rowangifford/harvestgeek/Hardware/Kicad/base_station_rev1.2_16MAY/gerbers/base_station_rev1.1-GERBERS_reduced_outline/README.txt

Harvest Geek Base Station V1.1
Engineer: Rowan Gifford
Contact: rowan.gifford@gmail.com
Tel: +447979880940
Date: 03 July 2014

2 layer PTH 1.6mm FR4 1 oz Cu I.S.

PCB size: 99mm x 57.72mm      (Ver 2, reduced outline 04 July 2014)

Files:

BASESTATION_BOARD_OUTLINE.gbr - PCB outline, standard 2mm router, no panalisation
BASESTATION_BOTMASK.gbs - Bottom layer solder mask
BASESTATION_BOTTOM.gbl - Bottom copper layer
BASESTATION_TOPMASK.gts - Top layer solder mask
BASESTATION_TOP.gtl - Top copper layer
BASESTATION_SILKTOP.gto - Top layer silkscreen
BASESTATION_DRILL.drl - Drill file, all plated through hole.
BASESTATION_ASSY.gto - Assembly file, shows component placement and references for population
