rowangifford/harvestgeek/Hardware/BOM/BoM_MoistureProbe_Rev1.0.xlsm

Project components for 1 prototype
 | Moisture Probe BOM
 | Version 1.0 (RG)
 | Date 16/06/2015
Item | Schematics Ref | Qty | Description | Manufacturer P/N | Manufacturer | Customer Supplied? | Component Fitted? | Packaging | Internet link
1 | K1 | 1 | CONN TERM BLK 3POS 3.5MM R/A PCB | 1824430000 | Weidmuller | No | Yes | TH | http://www.digikey.com/product-detail/en/1824430000/281-2021-ND/1094359
2 | Q1 | 1 | NPN Transistor 40V 0.6A | MMBT2222ALT3G | ON Semiconductor | No | Yes | SOT-23 | http://www.digikey.co.uk/product-detail/en/MMBT2222ALT3G/MMBT2222ALT3GOSTR-ND/1481928
3 | R1, R2 | 2 | 100 Ohm 1/8W Resistor | ESR03EZPJ101 | Rohm | No | Yes | SM-0603 | http://www.digikey.co.uk/product-detail/en/ESR03EZPJ101/RHM100DDKR-ND/1984100
 | Total: | 4
