rowangifford/harvestgeek/Hardware/BOM/BoM_SensorStation_Rev1.3.xlsm

Project components for 1 prototype
 | Sensor Station BOM
 | Version 1.3 (RG)
 | Date 20/06/2015
Item | Schematics Ref | Qty | Description | Manufacturer P/N | Manufacturer | Customer Supplied? | Component Fitted? | Packaging | Internet link
1 | P5 | 1 | CONN TERM BLK 2POS 3.5MM R/A PCB | 1824420000 | Weidmuller | No | Yes | TH | http://www.digikey.com/product-detail/en/1824420000/281-2020-ND/1094358
2 | K1 | 1 | CONN TERM BLK 3POS 3.5MM R/A PCB | 1824430000 | Weidmuller | No | Yes | TH | http://www.digikey.com/product-detail/en/1824430000/281-2021-ND/1094359
3 | CON1 | 1 | CONN RCPT STD MICRO USB TYPE B | 10103594-0001LF | FCI | No | Yes | TH/SMD | http://www.digikey.com/product-detail/en/10103594-0001LF/609-4050-1-ND/2350357
4 | CON2 | 1 | CONN HEADER 6POS .100 STR 15AU | 67996-206HLF | FCI | No | Yes | TH | http://www.digikey.com/product-detail/en/67996-206HLF/609-3210-ND/1878485
5 | U1 | 1 | IC REG LDO 3.3V 0.3A SOT23-3 | AP7333-33SAG-7 | Diodes Inc | No | Yes | SOT-23-3 | http://www.digikey.com/product-detail/en/AP7333-33SAG-7/AP7333-33SAG-7DICT-ND/2270852
6 | U2 | 1 | IC MCU 8BIT 32KB FLASH 44TQFP | ATMEGA32U4-AUR | Atmel | No | Yes | 44-TQFP | http://www.digikey.com/product-detail/en/ATMEGA32U4-AUR/ATMEGA32U4-AURCT-ND/3440960
7 | U3 | 1 | IC VREF SHUNT PREC 2.5V TO-92-3 | LT1009CLP | Texas Instruments | No | Yes | TO-92-3 | http://www.digikey.com/product-detail/en/LT1009CLP/296-9585-5-ND/379789
8 | U4 | 1 | IC LIGHT TO DGTL CONV 6-DFN | TSL2581FN | AMS-TAOS USA Inc | No | Yes | 6-DFN (2x2) | http://www.digikey.com/product-detail/en/TSL2581FN/TSL2581-FNCT-ND/3095315
9 | U5 | 1 | NRF24L01 RF module | NRF24L01 | Nordic | No | Yes | TH | From ebay (look for 2 PCS NRF24L01 2.4GHz)
10 | U6 | 1 | DHT22 temp & humidity sensor | AM2302 (or DHT22) | Aosong | No | Yes | TH | From ebay
11 | U7 | 1 | High side load switch | AP22802AW5-7 | Diodes Inc | No | Yes | SOT-23-5 | http://www.digikey.com/product-detail/en/AP22802AW5-7/AP22802AW5-7DICT-ND/4935003
12 | D1 | 1 | LED GREEN/RED BICOLOR 0606 | LTST-C195KGJRKT | Lite-On Inc | No | Yes | 0606 (1616 Metric) | http://www.digikey.com/product-detail/en/LTST-C195KGJRKT/160-1452-1-ND/386846
13 | SW1 | 1 | SWITCH TACTILE SPST-NO 0.05A 12V | FSM16JH | TE Connectivity | No | Yes | TH | http://www.digikey.com/product-detail/en/FSM16JH/450-1643-ND/1632529
14 | X1 | 1 | CRYSTAL 8MHZ 18PF SMD | ABLS-8.000MHZ-B2-T | Abracon Corporation | No | Yes | HC49/US | http://www.digikey.com/product-detail/en/ABLS-8.000MHZ-B2-T/535-9089-1-ND/675606
15 | FB3 | 1 | FERRITE CHIP 600 OHM 1300MA 0603 | BLM18KG601SN1D | Murata Electronics North America | No | Yes | 0603 (1608 Metric) | http://www.digikey.com/product-detail/en/BLM18KG601SN1D/490-5258-1-ND/1982781
16 | R1 R2 | 2 | RES 22.0 OHM 1/10W 1% 0603 SMD | RC0603FR-0722RL | Yageo | No | Yes | 0603 (1608 Metric) | http://www.digikey.com/product-detail/en/RC0603FR-0722RL/311-22.0HRCT-ND/730002
17 | R5 R6 R7 R8 R11 R13 | 6 | RES 1K OHM 1/10W 1% 0603 SMD | ERJ-3EKF1001V | Panasonic Electronic Components | No | Yes | 0603 (1608 Metric) | http://www.digikey.com/product-detail/en/ERJ-3EKF1001V/P1.00KHCT-ND/198071
18 | R3 R4 R9 R10 R12 R14 R15 | 7 | RES 10K OHM 1/10W 1% 0603 SMD | ERJ-3EKF1002V | Panasonic Electronic Components | No | Yes | 0603 (1608 Metric) | http://www.digikey.com/product-detail/en/ERJ-3EKF1002V/P10.0KHCT-ND/198102
19 | C9 C10 | 2 | CAP CER 18PF 50V 5% NP0 0603 | C1608C0G1H180J080AA | TDK Corporation | No | Yes | 0603 (1608 Metric) | http://www.digikey.com/product-detail/en/C1608C0G1H180J080AA/445-1272-1-ND/567674
20 | C3 C4 C5 C6 C8 C11 C12 C13 C14 C15 C16 C17 C18 C33 | 14 | CAP CER 0.1UF 50V 10% X7R 0603 | GRM188R71H104KA93D | Murata Electronics North America | No | Yes | 0603 (1608 Metric) | http://www.digikey.com/product-detail/en/GRM188R71H104KA93D/490-1519-1-ND/587854
21 | C1 C2 C7 C19 C20 C36 C39 | 7 | CAP CER 1UF 16V 10% X7R 0603 | EMK107B7105KA-T | Taiyo Yuden | No | Yes | 0603 (1608 Metric) | http://www.digikey.com/product-detail/en/EMK107B7105KA-T/587-1241-1-ND/931018
22 | SENS | 1 | THERMISTOR ASSEMBLY 10K OHM | USP10982 | US Sensor | No | No | Not PCB Mounted | http://www.digikey.com/product-detail/en/USP10982/615-1088-ND/2651606
23 | LP1 LP2 | 2 | LIGHT PIPE CLEAR 5MM LENS STRGHT | PLP5-2-750 | Bivar Inc | No | Yes | Optical | http://www.digikey.com/product-detail/en/PLP5-2-750/492-1308-ND/2407218
24 | BOX | 1 | ABS Enclosure - CNC modified | SL-30FTMBT | Polycase | Yes | Yes | Mechanical | http://www.polycase.com/sl-30f
25 | SCREW | 4 | Enclosure/PCB 4x5/8 blk thread forming screw | SCREWS-HL5/8-B | Polycase | Yes | Yes | Mechanical | http://www.polycase.com/sl-30f
26 | SPACER | 1 | ROUND SPACER M3 NYLON 3MM | R30-6700394 | Harwin Inc. | No | Yes | Mechanical | http://www.digikey.co.uk/product-detail/en/R30-6700394/952-1526-ND/2264507
 | Total: | 62
 |  |  | Revision Log
 |  |  | Date | Revision | Engineer | Changes
 |  |  | 20th June 2015 | 1.3 | RG | Added U7,R14,R15,C18,C19,C20
