rowangifford/harvestgeek/Hardware/BOM/BoM_BaseStation_Rev1.2.xlsm

Project components for 1 prototype
 | Sensor Station BOM
 | Version 1.2 (RG)
 | Date 22/05/2015
Item | Schematics Ref | Qty | Description | Manufacturer P/N | Manufacturer | Customer Supplied? | Component Fitted? | Packaging | Internet link
1 | CON1 | 1 | CONN RCPT STD MICRO USB TYPE B | 10103594-0001LF | FCI | No | Yes | TH/SMD | http://www.digikey.com/product-detail/en/10103594-0001LF/609-4050-1-ND/2350357
2 | CON2 | 1 | CONN HEADER 6POS .100 STR 15AU | 67996-206HLF | FCI | No | Yes | TH | http://www.digikey.com/product-detail/en/67996-206HLF/609-3210-ND/1878485
3 | J1 | 1 | CONNECTOR RJ45 | RB1-125BAG1A | Wiznet | No | Yes | TH | http://www.digikey.com/product-search/en?KeyWords=RB1-125BAG1A&WT.z_header=search_go
4 | U1 | 1 | IC REG LDO 3.3V 0.3A SOT23-3 | AP7333-33SAG-7 | Diodes Inc | No | Yes | SOT-23-3 | http://www.digikey.com/product-detail/en/AP7333-33SAG-7/AP7333-33SAG-7DICT-ND/2270852
5 | U2 | 1 | IC MCU 8BIT 32KB FLASH 44TQFP | ATMEGA32U4-AUR | Atmel | No | Yes | 44-TQFP | http://www.digikey.com/product-detail/en/ATMEGA32U4-AUR/ATMEGA32U4-AURCT-ND/3440960
6 | U3 | 1 | IC TCP/IP+MAC+PHY CONTROLLER | W5100 | WIZnet | No | Yes | 80-LQFP (10x10) | http://www.digikey.com/product-detail/en/W5100/1278-1002-ND/3829647
7 | U4 | 1 | LCD COG CHARCTER 20x4 STN BLUE | RX2004A-BIW | Raystar | Yes | Yes | TH | http://octopart.com/rx2004a-biw-raystar-30865298
8 | U5 | 1 | NRF24L01+ RF module | NRF24L01 | Nordic | No | Yes | TH | From ebay (look for 2 PCS NRF24L01 2.4GHz)
9 | U6 | 1 | I2C EEPROM 2KBIT MAC | 24AA02E48T-I/OT | Microchip | No | Yes | SOT-23-5 | http://www.digikey.com/product-detail/en/24AA02E48T-I%2FOT/24AA02E48T-I%2FOTCT-ND/2003468
10 | Q1 | 1 | MOSFET N-CH 60V 300MA SOT-23 | 2N7002,215 | NXP Semiconductors | No | Yes | TO-236AB | http://www.digikey.com/product-detail/en/2N7002,215/568-1369-1-ND/763366
11 | SW1 | 1 | SWITCH TACTILE SPST-NO 0.05A 12V | FSM16JH | TE Connectivity | No | Yes | TH | http://www.digikey.com/product-detail/en/FSM16JH/450-1643-ND/1632529
12 | X1 | 1 | CRYSTAL 8MHZ 18PF SMD | ABLS-8.000MHZ-B2-T | Abracon Corporation | No | Yes | HC49/US | http://www.digikey.com/product-detail/en/ABLS-8.000MHZ-B2-T/535-9089-1-ND/675606
13 | X2 | 1 | CRYSTAL 25MHZ 18PF SMD | ABLS-25.000MHZ-B4-F-T | Abracon Corporation | No | Yes | HC49/US | http://www.digikey.com/product-detail/en/ABLS-25.000MHZ-B4-F-T/535-10235-1-ND/2184270
14 | FB1 FB2 FB3 | 3 | FERRITE CHIP 600 OHM 1300MA 0603 | BLM18KG601SN1D | Murata Electronics North America | No | Yes | 0603 (1608 Metric) | http://www.digikey.com/product-detail/en/BLM18KG601SN1D/490-5258-1-ND/1982781
15 | C26 C27 | 2 | CAP CER 12PF 50V 5% NP0 0603 | C1608C0G1H120J080AA | TDK Corporation | No | Yes | 0603 (1608 Metric) | http://www.digikey.com/product-detail/en/C1608C0G1H120J080AA/445-1270-1-ND/567672
16 | C9 C10 | 2 | CAP CER 18PF 50V 5% NP0 0603 | C1608C0G1H180J080AA | TDK Corporation | No | Yes | 0603 (1608 Metric) | http://www.digikey.com/product-detail/en/C1608C0G1H180J080AA/445-1272-1-ND/567674
17 | C12 | 1 | CAP CER 10000PF 50V 10% X7R 0603 | C0603C103K5RACTU | Kemet | No | Yes | 0603 (1608 Metric) | http://www.digikey.com/product-detail/en/C0603C103K5RACTU/399-1091-1-ND/411366
18 | C3 C4 C5 C6 C8 C22 C23 C25 C28 C29 C30 C33 C34 C35 C37 C38 C40 C41 C42 | 19 | CAP CER 0.1UF 50V 10% X7R 0603 | GRM188R71H104KA93D | Murata Electronics North America | No | Yes | 0603 (1608 Metric) | http://www.digikey.com/product-detail/en/GRM188R71H104KA93D/490-1519-1-ND/587854
19 | C1 C2 C7 C13 C14 C15 C16 C17 C18 C19 C20 C36 C39 | 13 | CAP CER 1UF 16V 10% X7R 0603 | EMK107B7105KA-T | Taiyo Yuden | No | Yes | 0603 (1608 Metric) | http://www.digikey.com/product-detail/en/EMK107B7105KA-T/587-1241-1-ND/931018
20 | C11 C21 C24 C31 C32 | 5 | CAP CER 10UF 6.3V 20% X5R 0603 | 06036D106MAT2A | AVX Corporation | No | Yes | 0603 (1608 Metric) | http://www.digikey.com/product-detail/en/06036D106MAT2A/478-5318-1-ND/1950985
21 | R1 R2 | 2 | RES 22.0 OHM 1/10W 1% 0603 SMD | RC0603FR-0722RL | Yageo | No | No | 0603 (1608 Metric) | http://www.digikey.com/product-detail/en/RC0603FR-0722RL/311-22.0HRCT-ND/730002
22 | R7, R16 | 2 | RES 66.5 OHM 1/10W 1% 0603 SMD | RC0603FR-0766R5L | Yageo | No | Yes | 0603 (1608 Metric) | http://www.digikey.com/product-detail/en/RC0603FR-0766R5L/311-66.5HRTR-ND/727347
23 | R17 R18 R19 R20 | 4 | RES 49.9 OHM 1/10W 1% 0603 SMD | RC0603FR-0749R9L | Yageo | Yes | Yes | 0603 (1608 Metric) | http://www.digikey.com/product-detail/en/RC0603FR-0749R9L/311-49.9HRCT-ND/730211
24 | R15 | 1 | RES 300 OHM 1/10W 1% 0603 SMD | ERJ-3EKF3000V | Panasonic Electronic Components | Yes | Yes | 0603 (1608 Metric) | http://www.digikey.com/product-detail/en/ERJ-3EKF3000V/P300HCT-ND/1746756
25 | R11 R13 R14 | 3 | RES 1K OHM 1/10W 1% 0603 SMD | ERJ-3EKF1001V | Panasonic Electronic Components | No | Yes | 0603 (1608 Metric) | http://www.digikey.com/product-detail/en/ERJ-3EKF1001V/P1.00KHCT-ND/198071
26 | R3 R4 R5 R6 R10 R12, R21, R22 | 8 | RES 10K OHM 1/10W 1% 0603 SMD | ERJ-3EKF1002V | Panasonic Electronic Components | No | Yes | 0603 (1608 Metric) | http://www.digikey.com/product-detail/en/ERJ-3EKF1002V/P10.0KHCT-ND/198102
27 | R9 | 1 | RES 12K OHM 1/10W 1% 0603 SMD | ERJ-3EKF1202V | Panasonic Electronic Components | No | Yes | 0603 (1608 Metric) | http://www.digikey.com/product-detail/en/ERJ-3EKF1202V/P12.0KHCT-ND/1746728
28 | R8 | 1 | RES 1.00M OHM 1/10W 1% 0603 SMD | RC0603FR-071ML | Yageo | No | Yes | 0603 (1608 Metric) | http://www.digikey.com/product-detail/en/RC0603FR-071ML/311-1.00MHRCT-ND/729791
29 | BOX | 1 | ABS Enclosure - CNC modified | SL-42FXXT | Polycase | Yes | Yes | Mechanical | http://www.polycase.com/sl-42f
30 | SCREW | 4 | Enclosure/PCB 4x1 blk thread forming screw | SCREWS-HL1-BR | Polycase | Yes | Yes | Mechanical | http://www.polycase.com/sl-42f
31 | SPACER | 4 | ROUND SPACER M3 NYLON 3MM | R30-6700394 | Harwin Inc. | No | Yes | Mechanical | http://www.digikey.co.uk/product-detail/en/R30-6700394/952-1526-ND/2264507
 | Total: | 89
 |  |  |  | Revision Log
 |  |  |  | Date | Revision | Engineer | Changes
 |  |  |  | 3rd June 2014 | 1.1 | RG | Added item 26, SW1
 |  |  |  | 3rd July 2014 | 1.1 | RG | Changed U4 to RX2004-BIW character display. Added R7 R16 LED backlight resistors, R21 R22 I2C Pullups
 |  |  |  | 17th May 2014 | 1.2 | RG | Added U6 EEPROM, Mechanical spacers, changed enclosure and re-order
