rowangifford/harvestgeek/Hardware/Manufacturing Outputs/Moisture Probe/moisture_probe_rev1.0_manufacturing_files/README.txt

Harvest Geek Moisture Probe V1.0
Engineer: Rowan Gifford
Contact: rowan.gifford@gmail.com
Date: 16th June 2015

2 layer PTH 1.6mm FR4 1 oz Cu ENIG
PCB size: 21mm x 64mm

No components or silk bottom layer.

Drill file:
Units: mm
Zero's Format: Decimal
File Format: PostScript
Drill origin: Fiducial 1 0,0

Files:

PROBE_BOARD_OUTLINE.gbr - PCB outline, standard 2mm router, no panalisation
PROBE_BOTTOM_MASK.gbr - Bottom layer solder mask
PROBE_BOTTOM_COPPER.gbr - Bottom copper layer
PROBE_TOP_MASK.gbr - Top layer solder mask
PROBE_TOP_COPPER.gbr - Top copper layer
PROBE_TOP_PASTE.gbr - Top solde paste layer (no paste on bottom layer)
PROBE_TOP_SILK.gbr - Top layer silkscreen (no silkscreen on bottom layer)
PROBE_DRILL.drl - Drill file, all plated through hole.
PROBE_TOP_ASSY.pdf - Top assembly file, shows component placement and references for population
PROBE_TOP_POS.pos - Top layer pick and place position file. Origin 0,0 is located at fiducial FID1. Zero orientation follows IPC-7351C Level A (Pin 1 in Upper left). No SMD on bottom layer.
