rowangifford/harvestgeek/Hardware/Manufacturing Outputs/Base Station/base_station_PCB_guide.pdf

## Harvest Geek Base Station PCB Assembly Guide

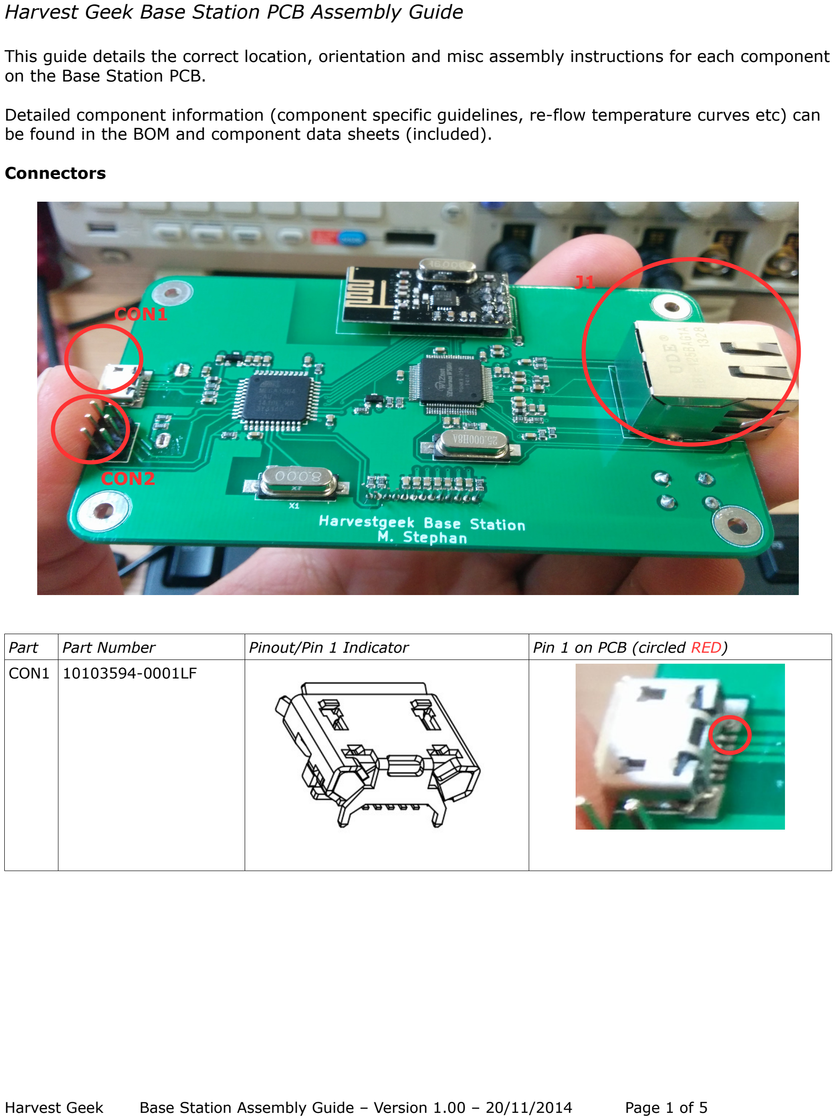
[picture p15: page 1]

This guide details the correct location, orientation and misc assembly instructions for each component on the Base Station PCB.

Detailed component information (component specific guidelines, re-flow temperature curves etc) can be found in the BOM and component data sheets (included).

Connectors

Part | Part Number | Pinout/Pin 1 Indicator | Pin 1 on PCB (circled RED)
CON1 | 10103594-0001LF
Harvest Geek | Base Station Assembly Guide – Version 1.00 – 20/11/2014 | Page 1 of 5

J1

### CON1

### CON2

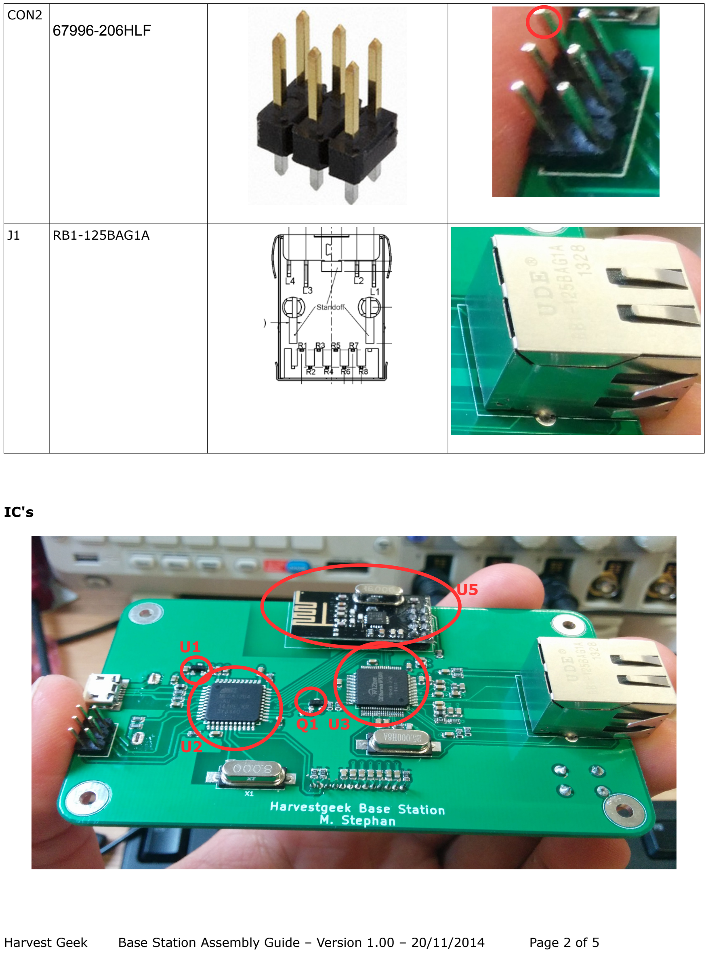
[picture p16: page 2]

CON2 | 67996-206HLF
J1 | RB1-125BAG1A

IC's

Harvest Geek | Base Station Assembly Guide – Version 1.00 – 20/11/2014 | Page 2 of 5

U1

U2

Q1 U3

U5

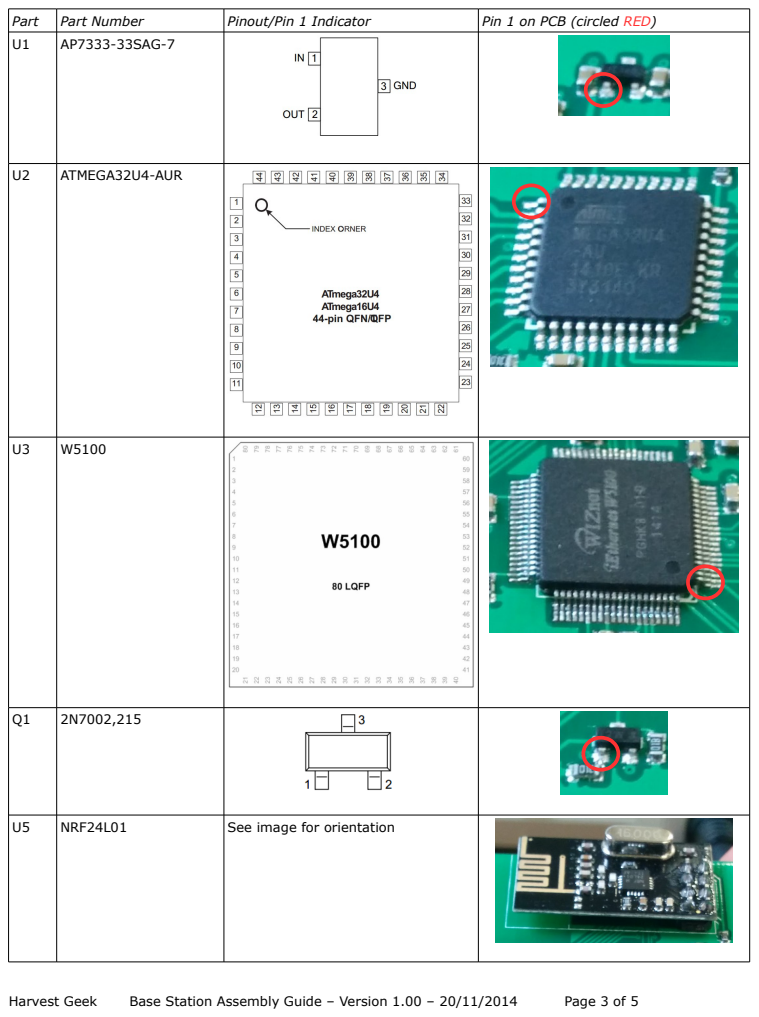
[picture p17: page 3]
Harvest Geek; Base Station Assembly Guide – Version 1.00 – 20/11/2014; Page 3 of 5

Part | Part Number | Pinout/Pin 1 Indicator | Pin 1 on PCB (circled RED)
U1 | AP7333-33SAG-7

U2 | ATMEGA32U4-AUR

U5 | NRF24L01 | See image for orientation

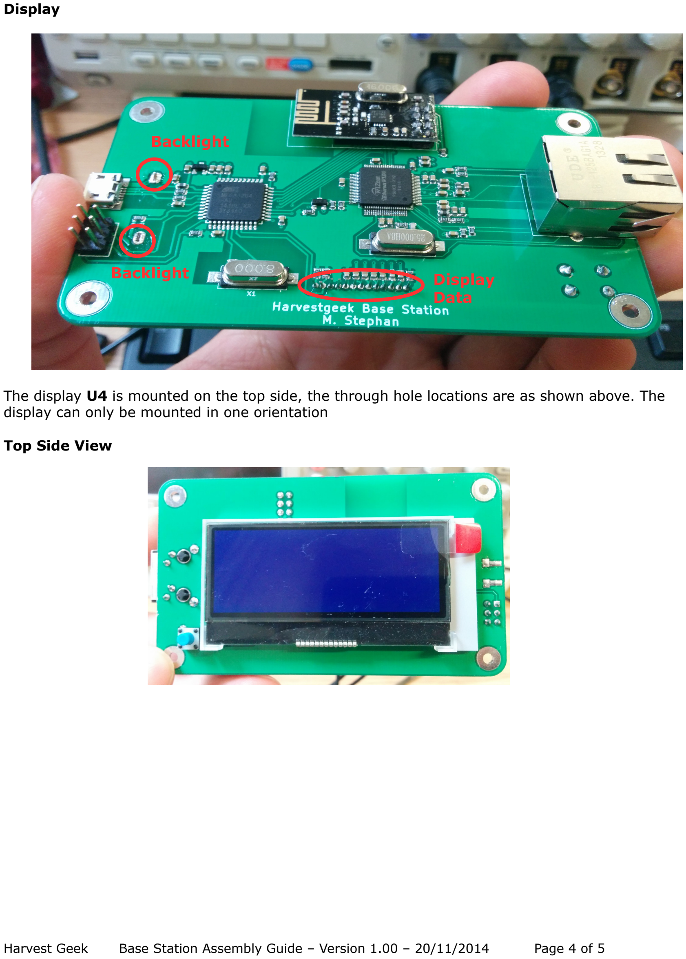
[picture p18: page 4]

Display

The display U4 is mounted on the top side, the through hole locations are as shown above. The display can only be mounted in one orientation

Top Side View

Harvest Geek | Base Station Assembly Guide – Version 1.00 – 20/11/2014 | Page 4 of 5

### Backlight

Backlight | Display Data

Push Button Switch SW1

To be mounted on the TOP side as pictured.

Passives

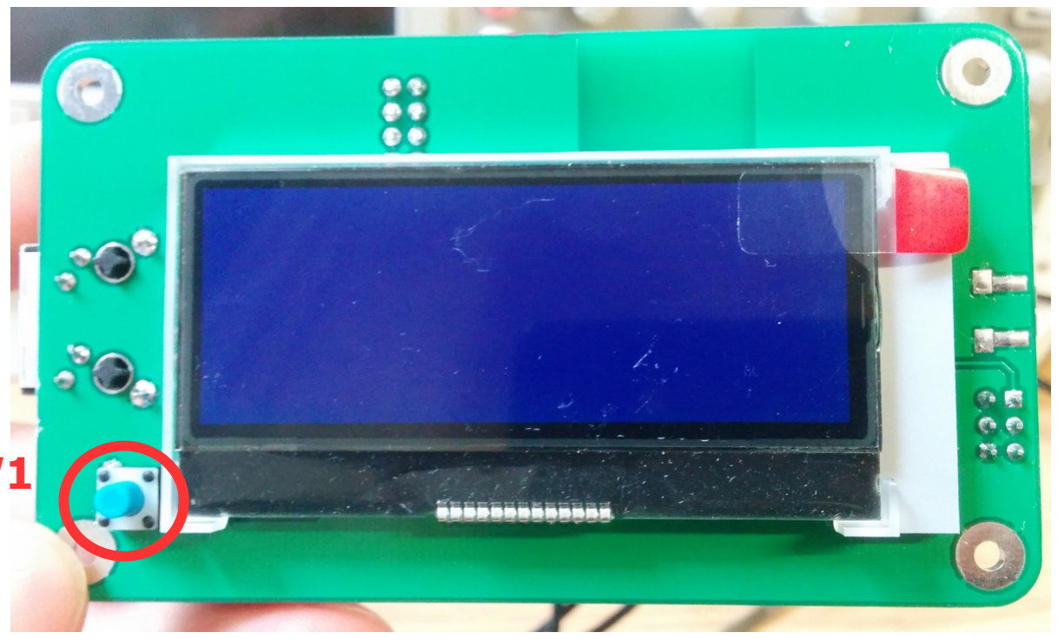
[picture p19: figure]

Capacitors, resistors, inductors and non-polarised component not detailed as they are not orientation specific. See BOM.

Harvest Geek | Base Station Assembly Guide – Version 1.00 – 20/11/2014 | Page 5 of 5

SW1
