rowangifford/harvestgeek/Hardware/Manufacturing Outputs/Sensor Station/sensor_station_PCB_guide.pdf

## Harvest Geek Sensor Station PCB Assembly Guide

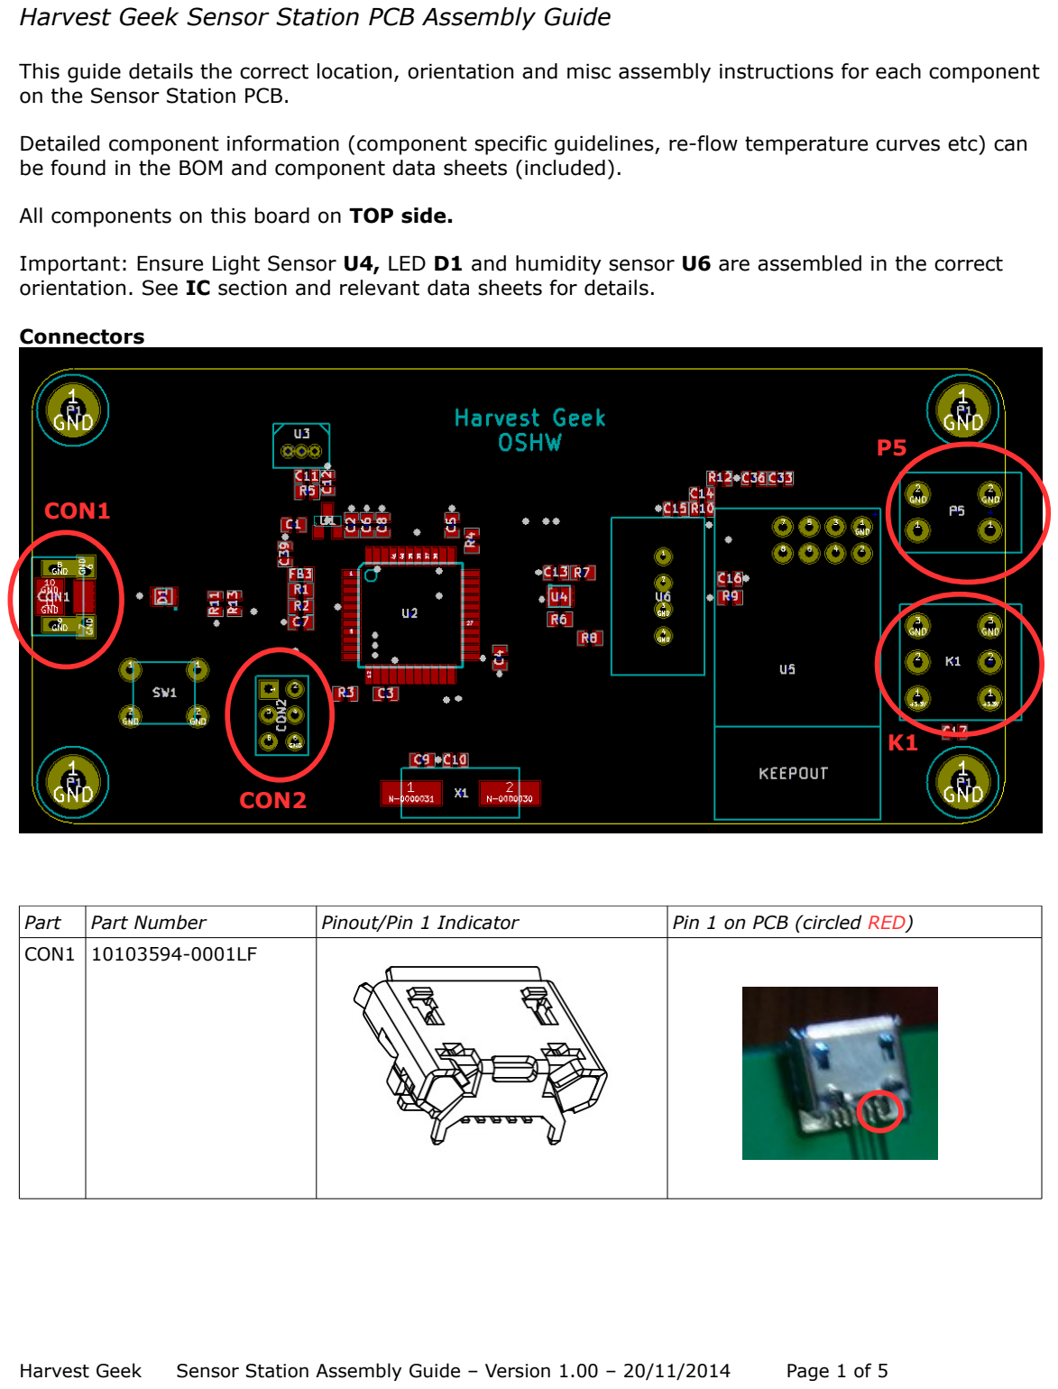
[picture p20: page 1]

This guide details the correct location, orientation and misc assembly instructions for each component on the Sensor Station PCB.

Detailed component information (component specific guidelines, re-flow temperature curves etc) can be found in the BOM and component data sheets (included).

All components on this board on TOP side.

Important: Ensure Light Sensor U4, LED D1 and humidity sensor U6 are assembled in the correct orientation. See IC section and relevant data sheets for details.

Connectors

Part | Part Number | Pinout/Pin 1 Indicator | Pin 1 on PCB (circled RED)
CON1 | 10103594-0001LF
Harvest Geek | Sensor Station Assembly Guide – Version 1.00 – 20/11/2014 | Page 1 of 5

K1

### CON1

### CON2

P5

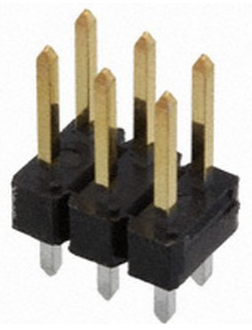
[picture p21: figure]

CON2 | 67996-206HLF

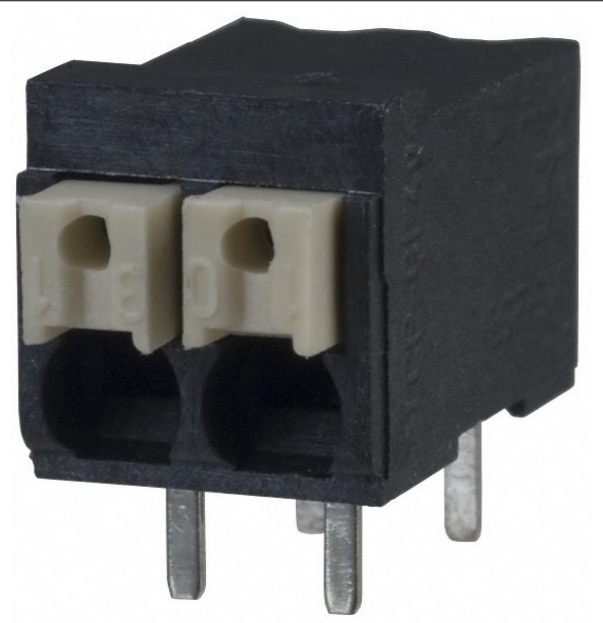
[picture p22: figure]
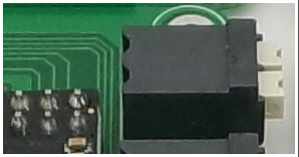
[picture p23: figure]

P5 | 1824420000

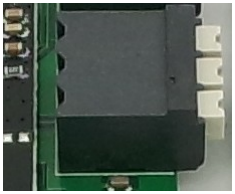
[picture p24: figure]
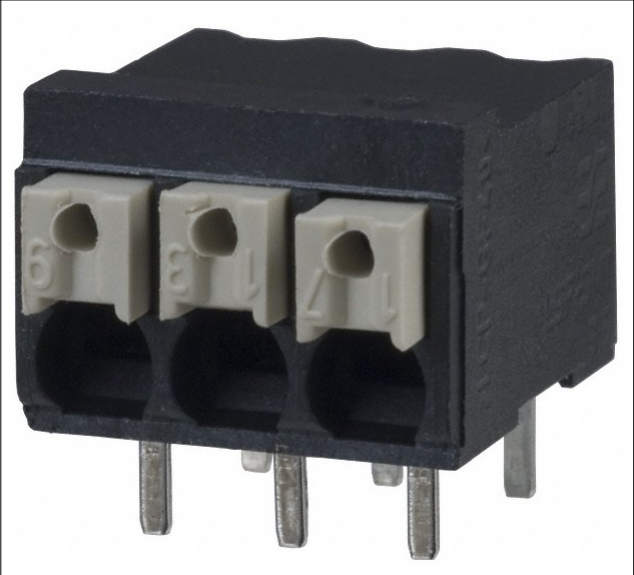
[picture p25: figure]

K1 | 1824430000
Harvest Geek | Sensor Station Assembly Guide – Version 1.00 – 20/11/2014 | Page 2 of 5

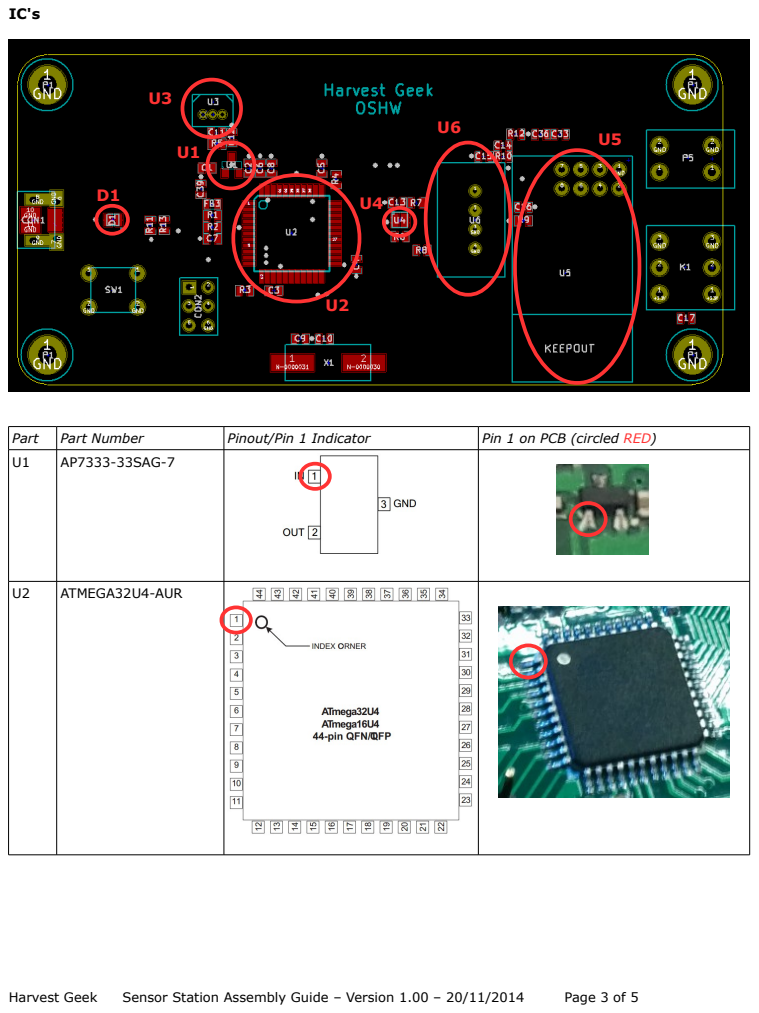
[picture p26: page 3]
Harvest Geek; Sensor Station Assembly Guide – Version 1.00 – 20/11/2014; Page 3 of 5

Part | Part Number | Pinout/Pin 1 Indicator | Pin 1 on PCB (circled RED)
U1 | AP7333-33SAG-7

U2 | ATMEGA32U4-AUR

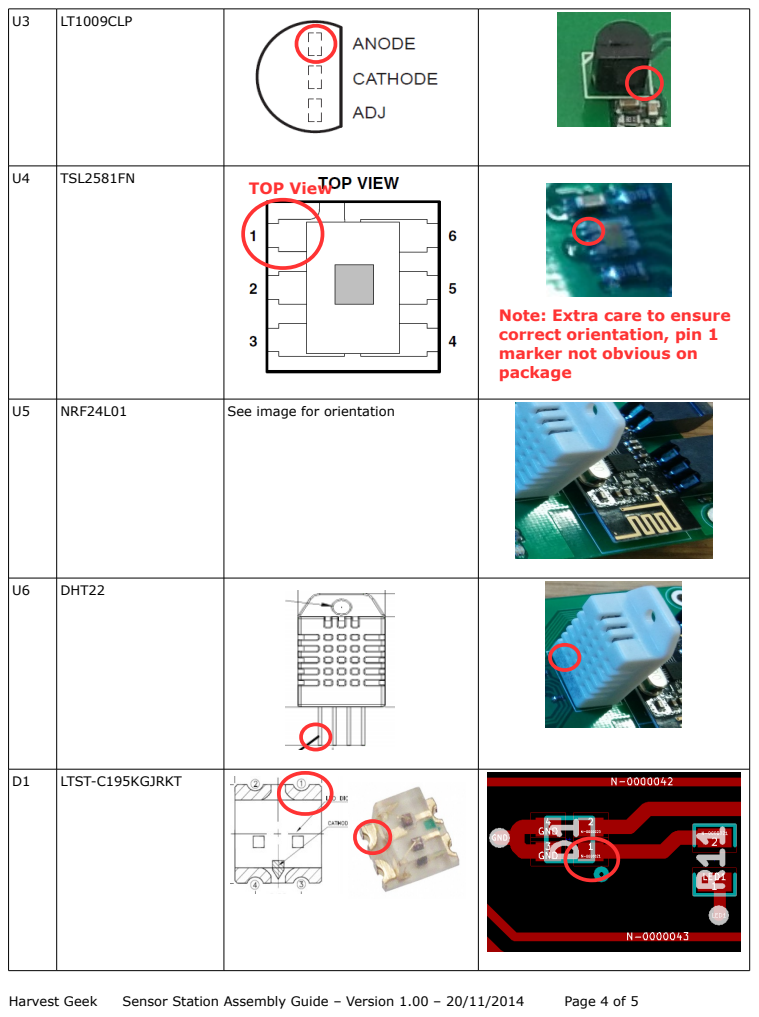
[picture p27: page 4]
Harvest Geek; Sensor Station Assembly Guide – Version 1.00 – 20/11/2014; Page 4 of 5

U3 | LT1009CLP

U4 | TSL2581FN | TOP View | Note: Extra care to ensure correct orientation, pin 1 marker not obvious on package

U5 | NRF24L01 | See image for orientation

U6 | DHT22

D1 | LTST-C195KGJRKT

Push Button Switch SW1

To be mounted on the TOP side as pictured.

Passives

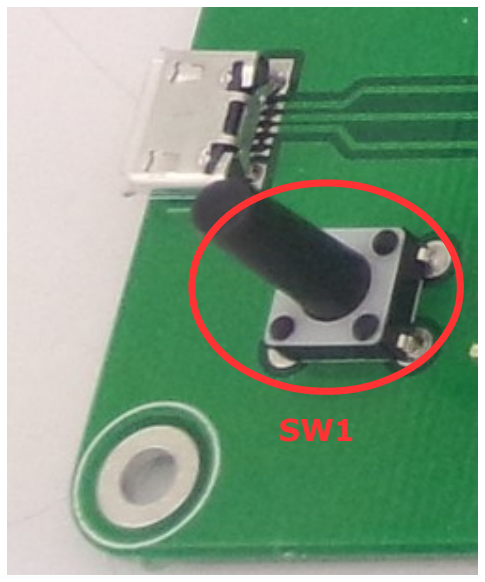
[picture p28: figure]

Capacitors, resistors, inductors and non-polarised component not detailed as they are not orientation specific. See BOM.

Harvest Geek | Sensor Station Assembly Guide – Version 1.00 – 20/11/2014 | Page 5 of 5
