rowangifford/harvestgeek/Hardware/Manufacturing Outputs/Sensor Station/sensor_station_TEST_procedure.pdf

### Harvest Geek Sensor Station Test Procedure

Follow the below power on test procedure after component assembly and firmware burning.

1. Insert 5V power (micro USB cable) as shown below
2. Inspect LED D1 (circled below, top side PCB shown) and asses against PASS or FAIL criteria in table below.
3. If unit meets a FAIL criteria fill out a failure mode document.

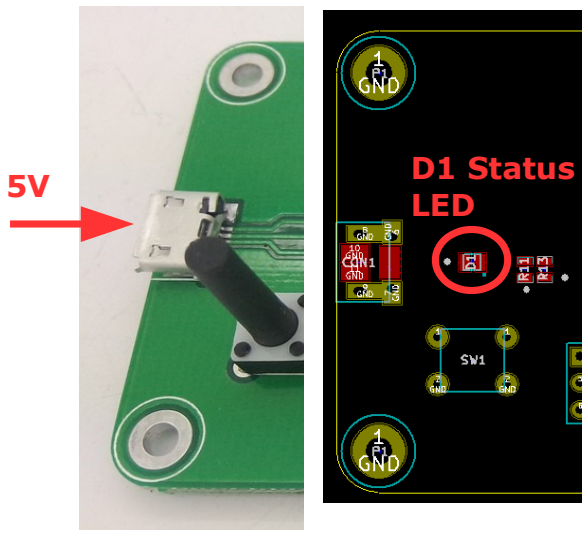
[picture p30: figure]
D1 Status; LED

PASS

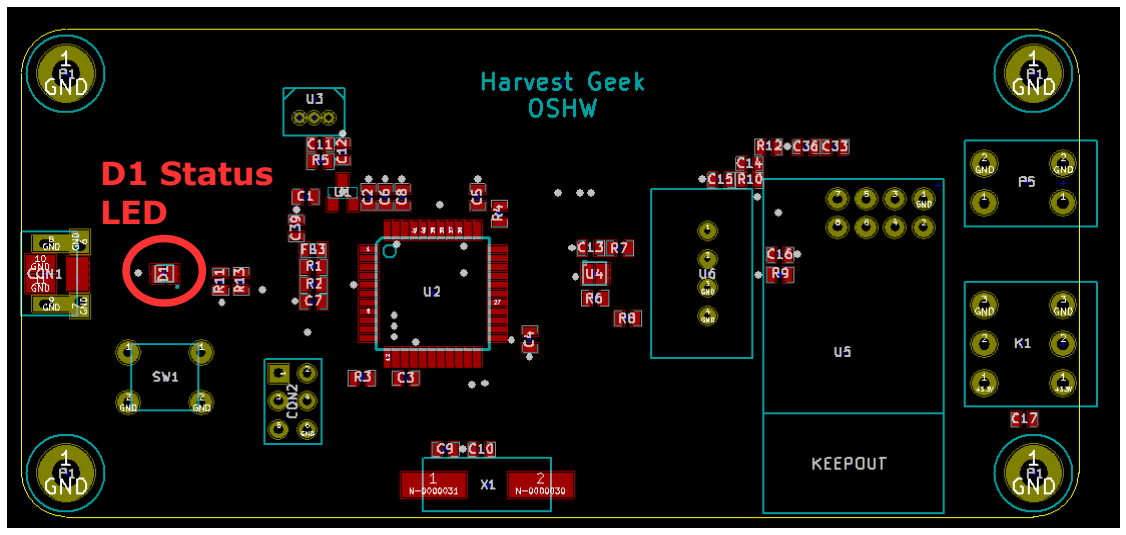
[picture p31: figure]

Light Status | Status
Blinking GREEN | OK, not connected to base station
Solid GREEN | OK, connected to base station

FAIL

Light Status | Error
Solid RED | Light sensor communication
Blinking RED | Humidity sensor communication
Solid GREEN & RED | NRF module communication
Blinking alternately RED & GREEN | No PID in EEPROM
NO light | LED failure
Harvest Geek | Sensor Station Test Procedure – Version 1.00 – 20/11/2014 | Page 1 of 2

### Failure mode documents

Light Status | Error | Check | Test Operator | Date
Solid RED | Light sensor | □
Blinking RED | Humidity sensor | □
Solid GREEN & RED | NRF module | □
Blinking alternately RED & GREEN | No PID in EEPROM | □
NO light | LED failure | □
Light Status | Error | Check | Test Operator | Date
Solid RED | Light sensor | □
Blinking RED | Humidity sensor | □
Solid GREEN & RED | NRF module | □
Blinking alternately RED & GREEN | No PID in EEPROM | □
NO light | LED failure | □
Light Status | Error | Check | Test Operator | Date
Solid RED | Light sensor | □
Blinking RED | Humidity sensor | □
Solid GREEN & RED | NRF module | □
Blinking alternately RED & GREEN | No PID in EEPROM | □
NO light | LED failure | □
Light Status | Error | Check | Test Operator | Date
Solid RED | Light sensor | □
Blinking RED | Humidity sensor | □
Solid GREEN & RED | NRF module | □
Blinking alternately RED & GREEN | No PID in EEPROM | □
NO light | LED failure | □
Light Status | Error | Check | Test Operator | Date
Solid RED | Light sensor | □
Blinking RED | Humidity sensor | □
Solid GREEN & RED | NRF module | □
Blinking alternately RED & GREEN | No PID in EEPROM | □
NO light | LED failure | □
Harvest Geek | Sensor Station Test Procedure – Version 1.00 – 20/11/2014 | Page 2 of 2
