rowangifford/harvestgeek/Hardware/Kicad/Moisture_probe_rev1.0_07JUN/moisture_probe-F_SilkS.pdf

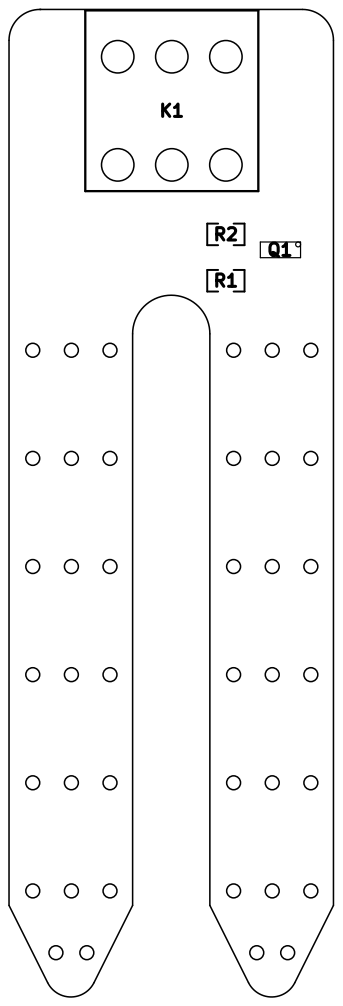
[picture p32: page 1]
