rowangifford/harvestgeek/Hardware/Kicad/base_station_rev1.2_16MAY/schematics_rev1.1_RG.pdf

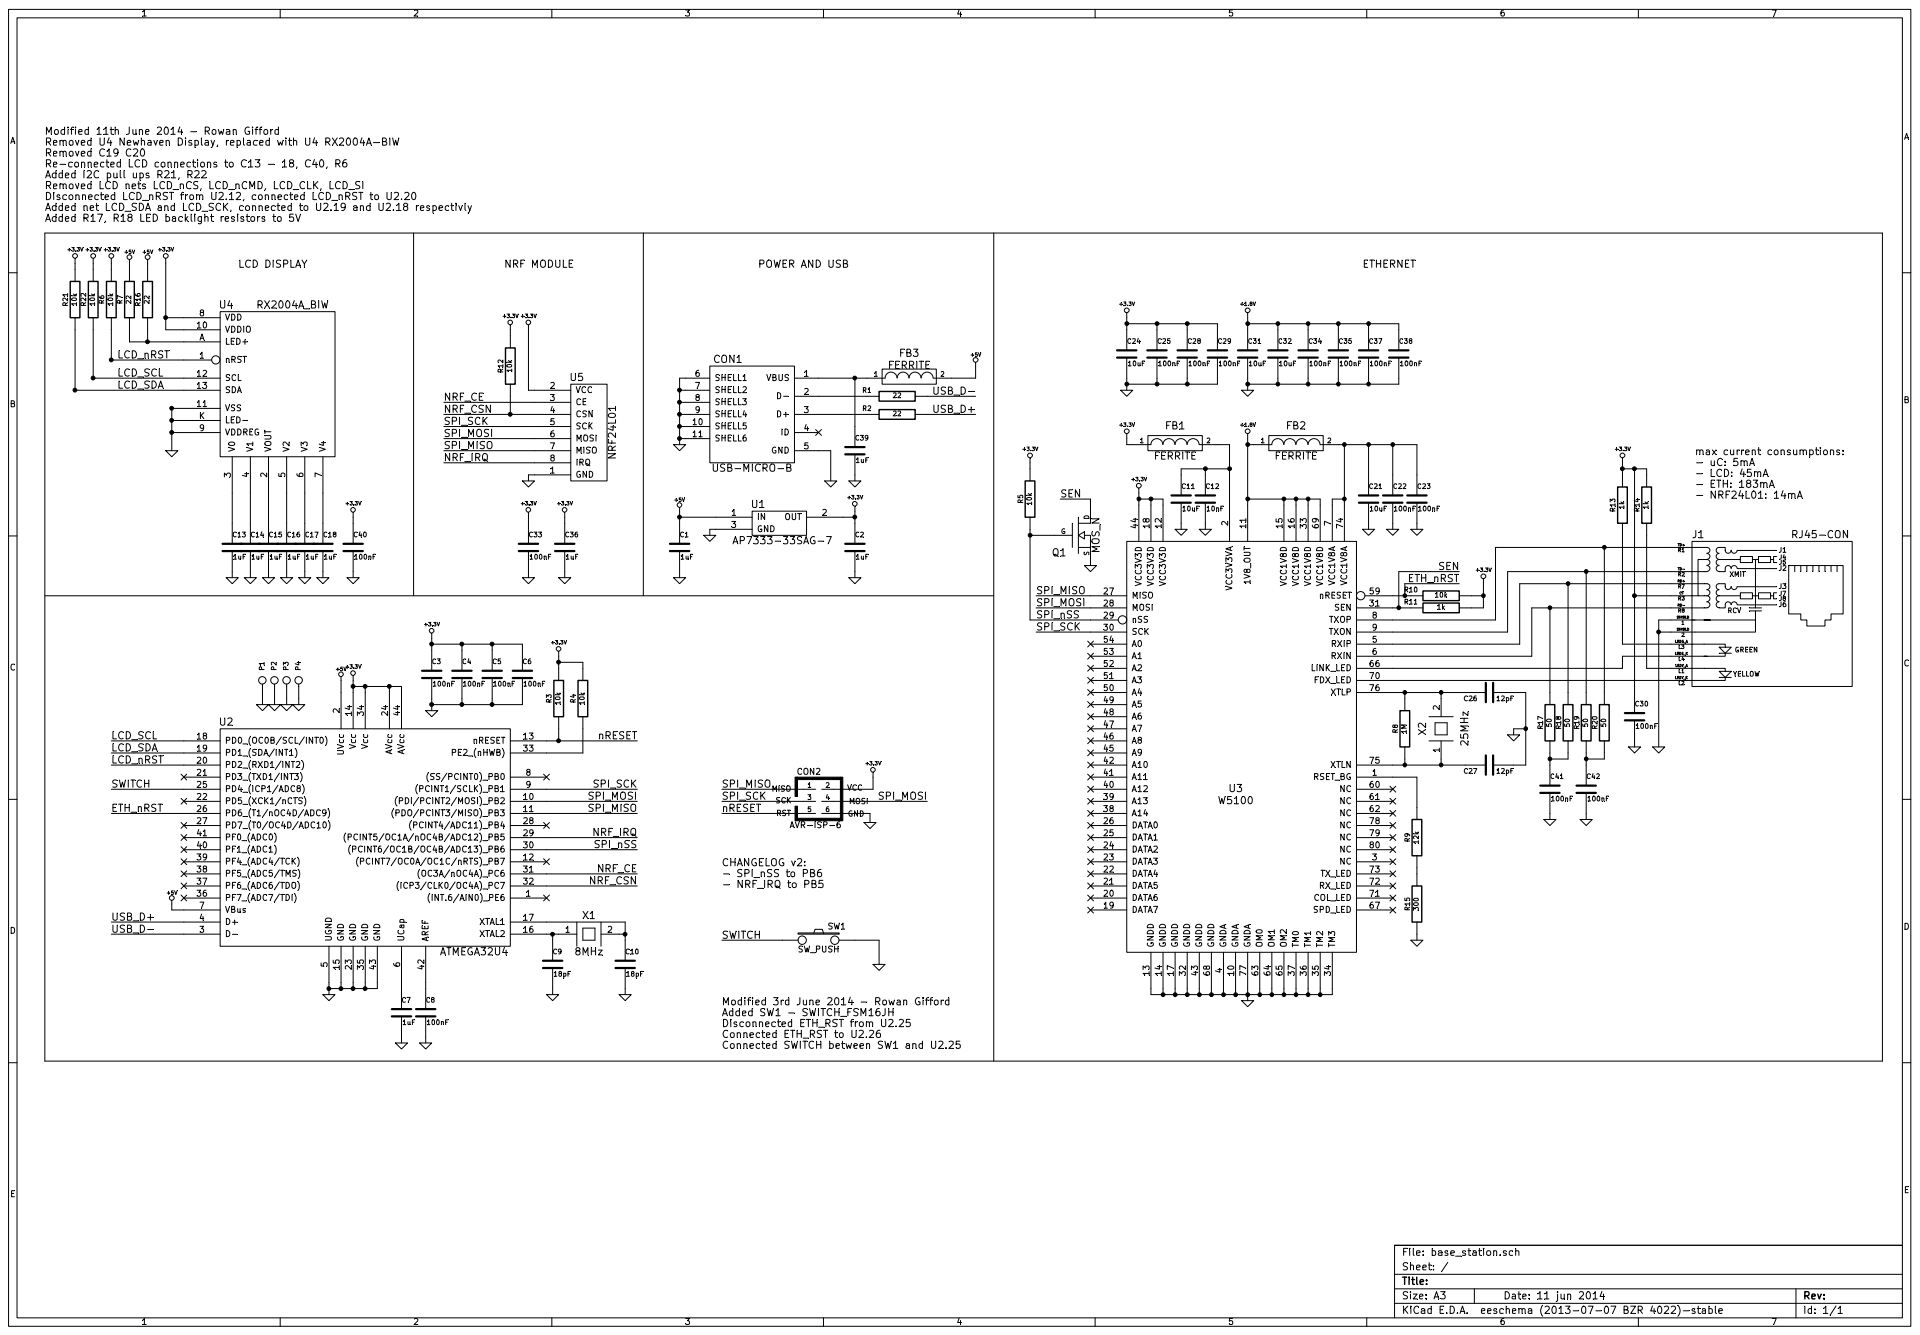
[picture p33: page 1]
