rowangifford/harvestgeek/Hardware/Kicad/sensor_station_rev1.2_22MAY/schematics.pdf

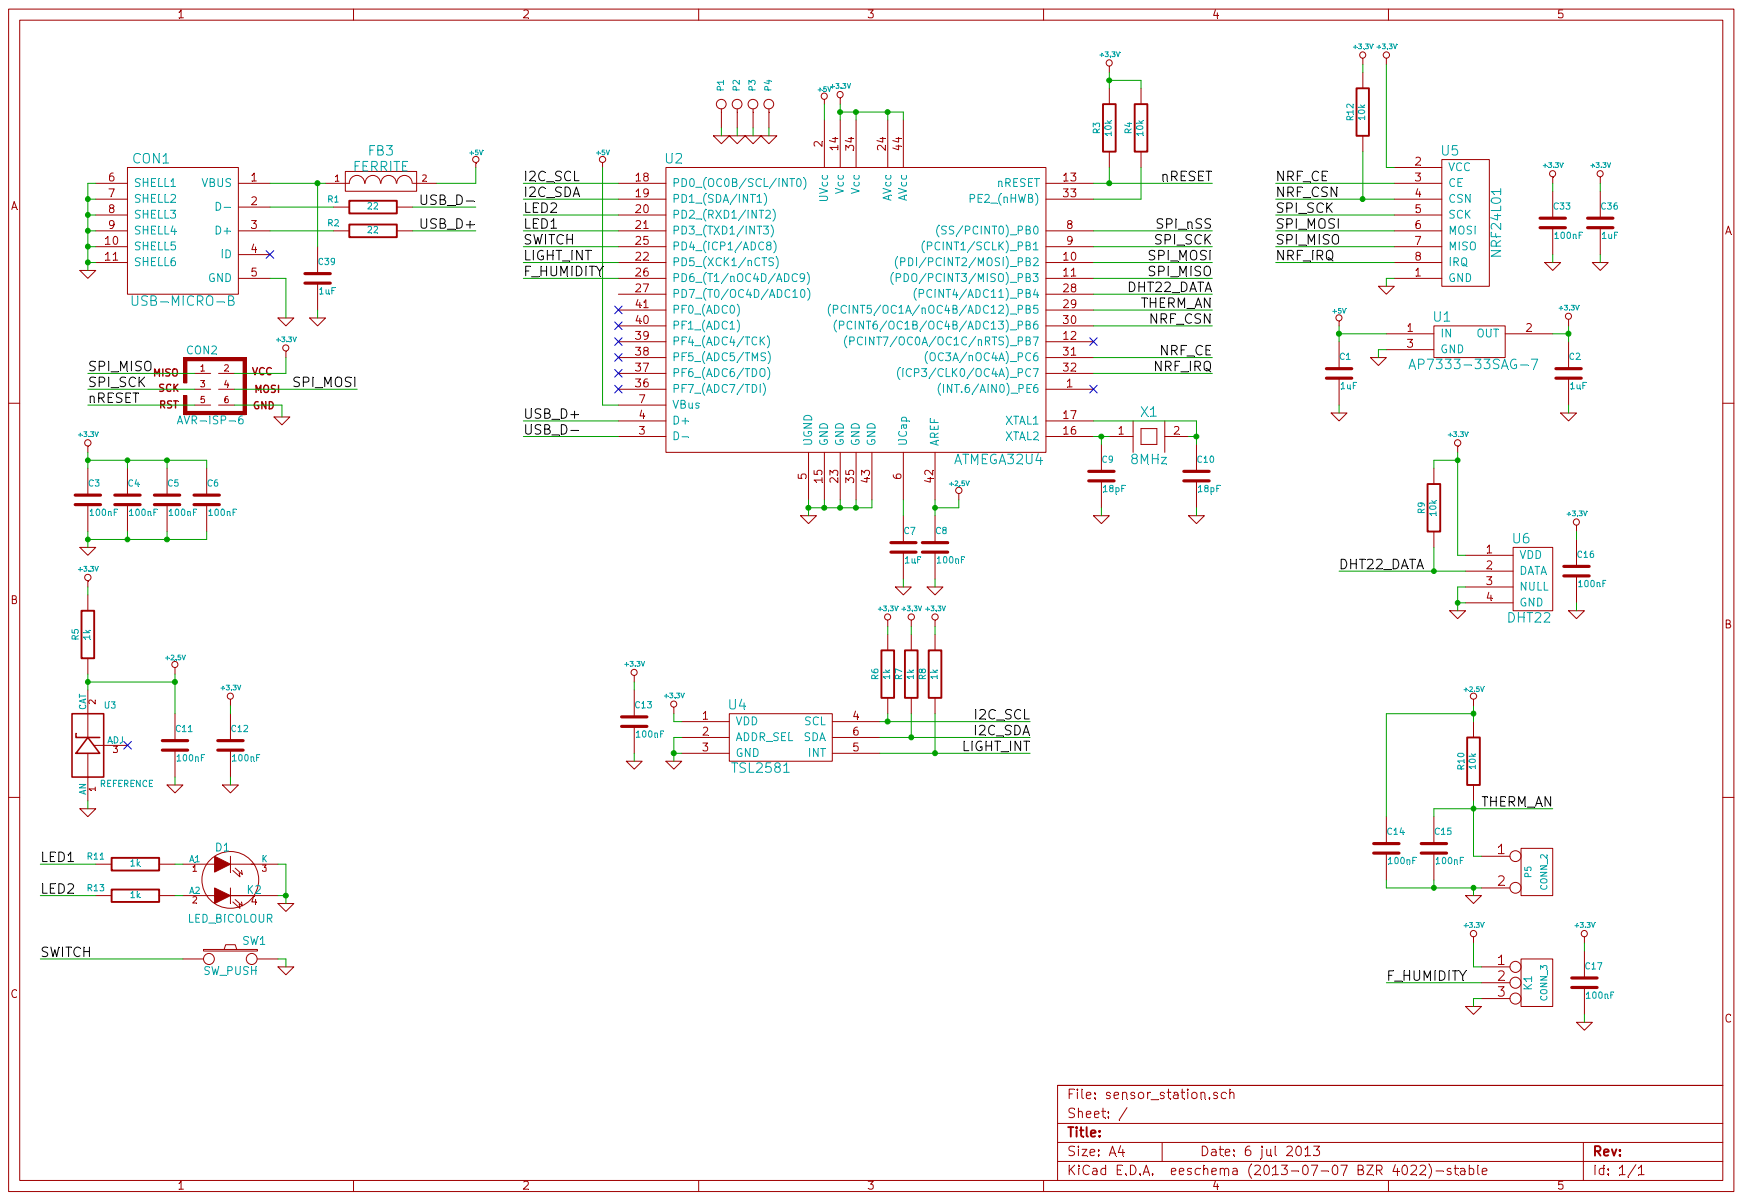
[picture p34: page 1]
