rowangifford/harvestgeek/Hardware/Manufacturing Outputs/Sensor Station/sensorstation_rev1.3_manufacturing_files/SENSORSTATION_TOP_ASSY.pdf

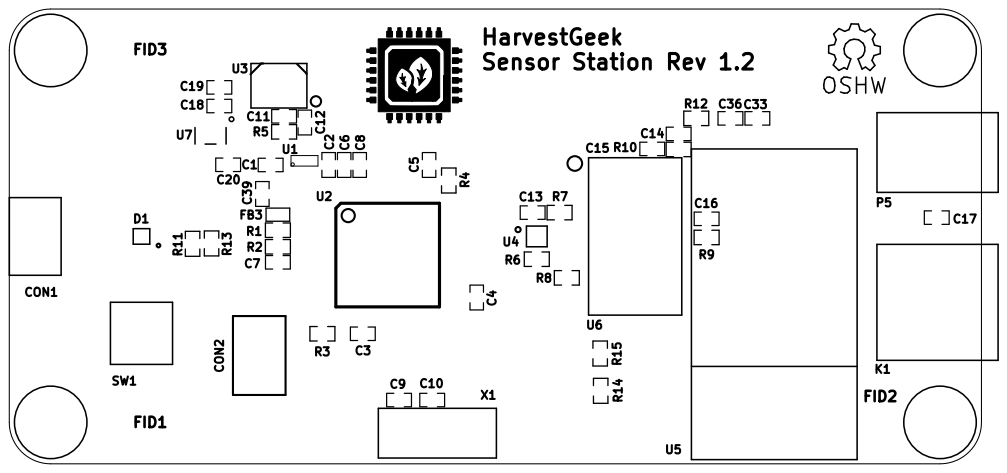
[picture p35: page 1]
