rowangifford/harvestgeek/Hardware/Manufacturing Outputs/Base Station/basestation_rev1.2_manufacturing_files/BASESTATION_BOTTOM_ASSY.pdf

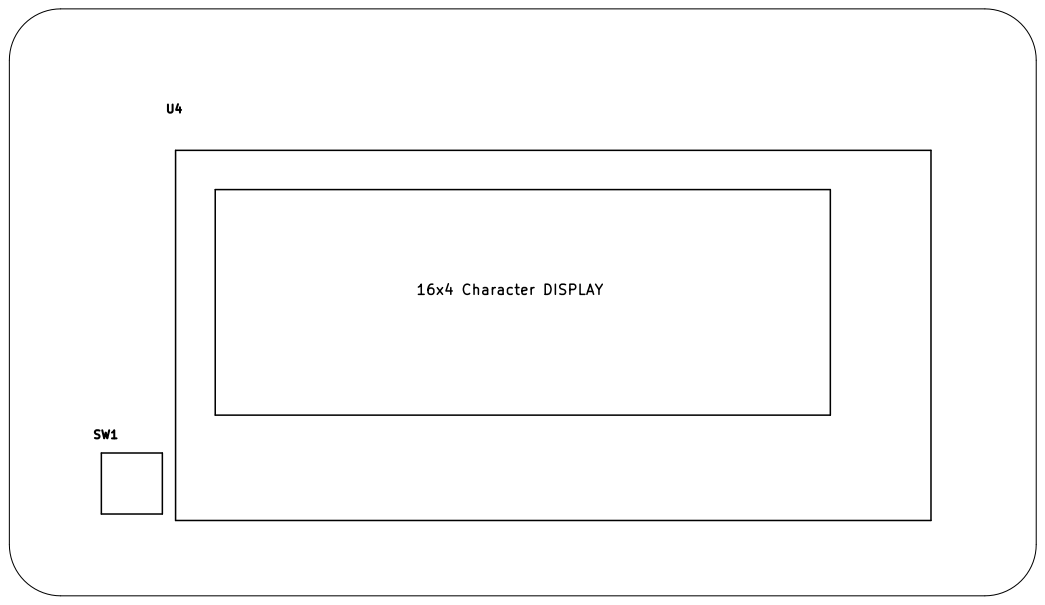
[picture p36: page 1]
