rowangifford/harvestgeek/Hardware/Manufacturing Outputs/Base Station/basestation_rev1.2_manufacturing_files/BASESTATION_TOP_ASSY.pdf

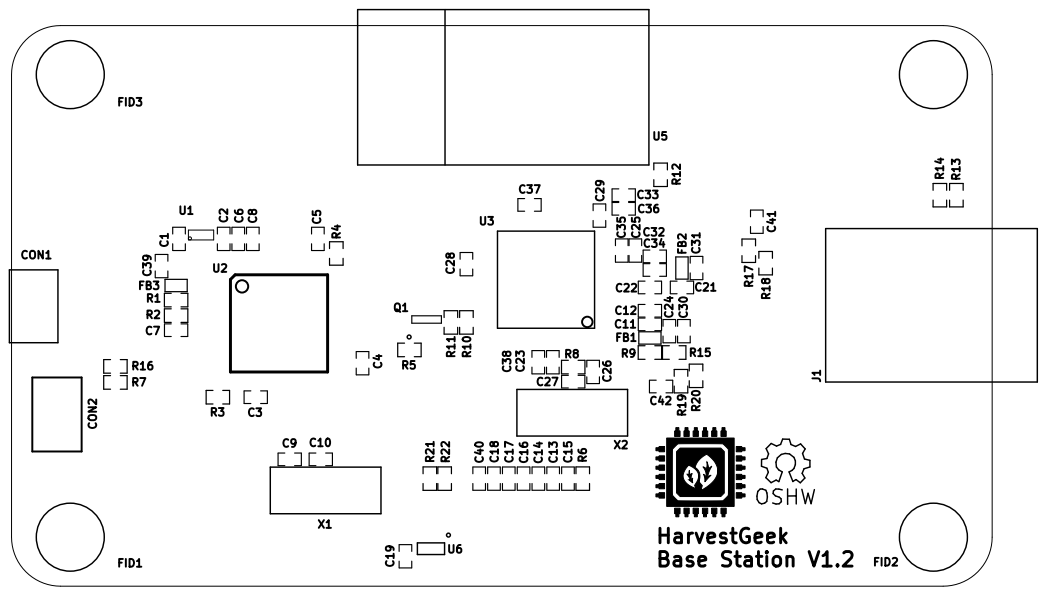
[picture p37: page 1]
