rowangifford/harvestgeek/Hardware/Kicad/sensor_station_rev1.2_22MAY/gerbers/sensorstation_rev1.2_manufacturing_files/SENSORSTATION_TOP_ASSY.pdf

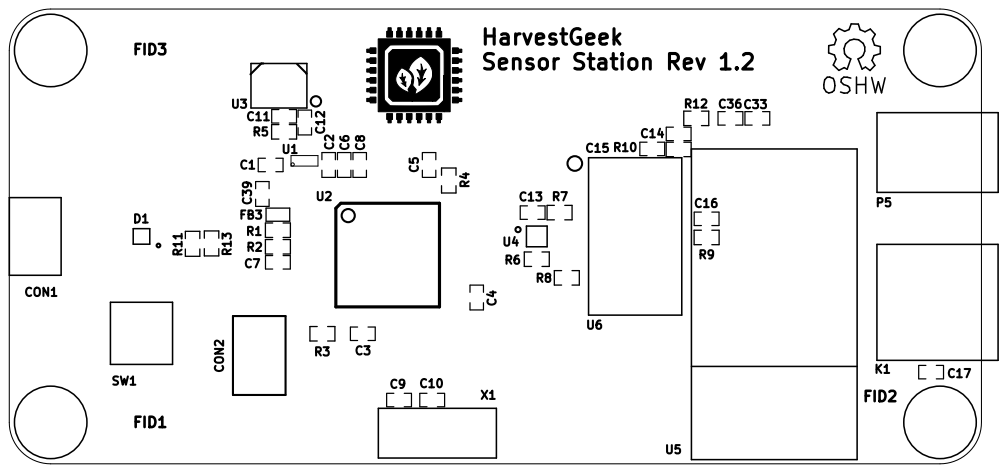
[picture p38: page 1]
