rowangifford/harvestgeek/Hardware/Kicad/sensor_station_rev1.2_22MAY/sensor_station.kicad_pcb

## KiCad design Hardware/Kicad/sensor_station_rev1.2_22MAY/sensor_station.kicad_pcb (2015-06-23)

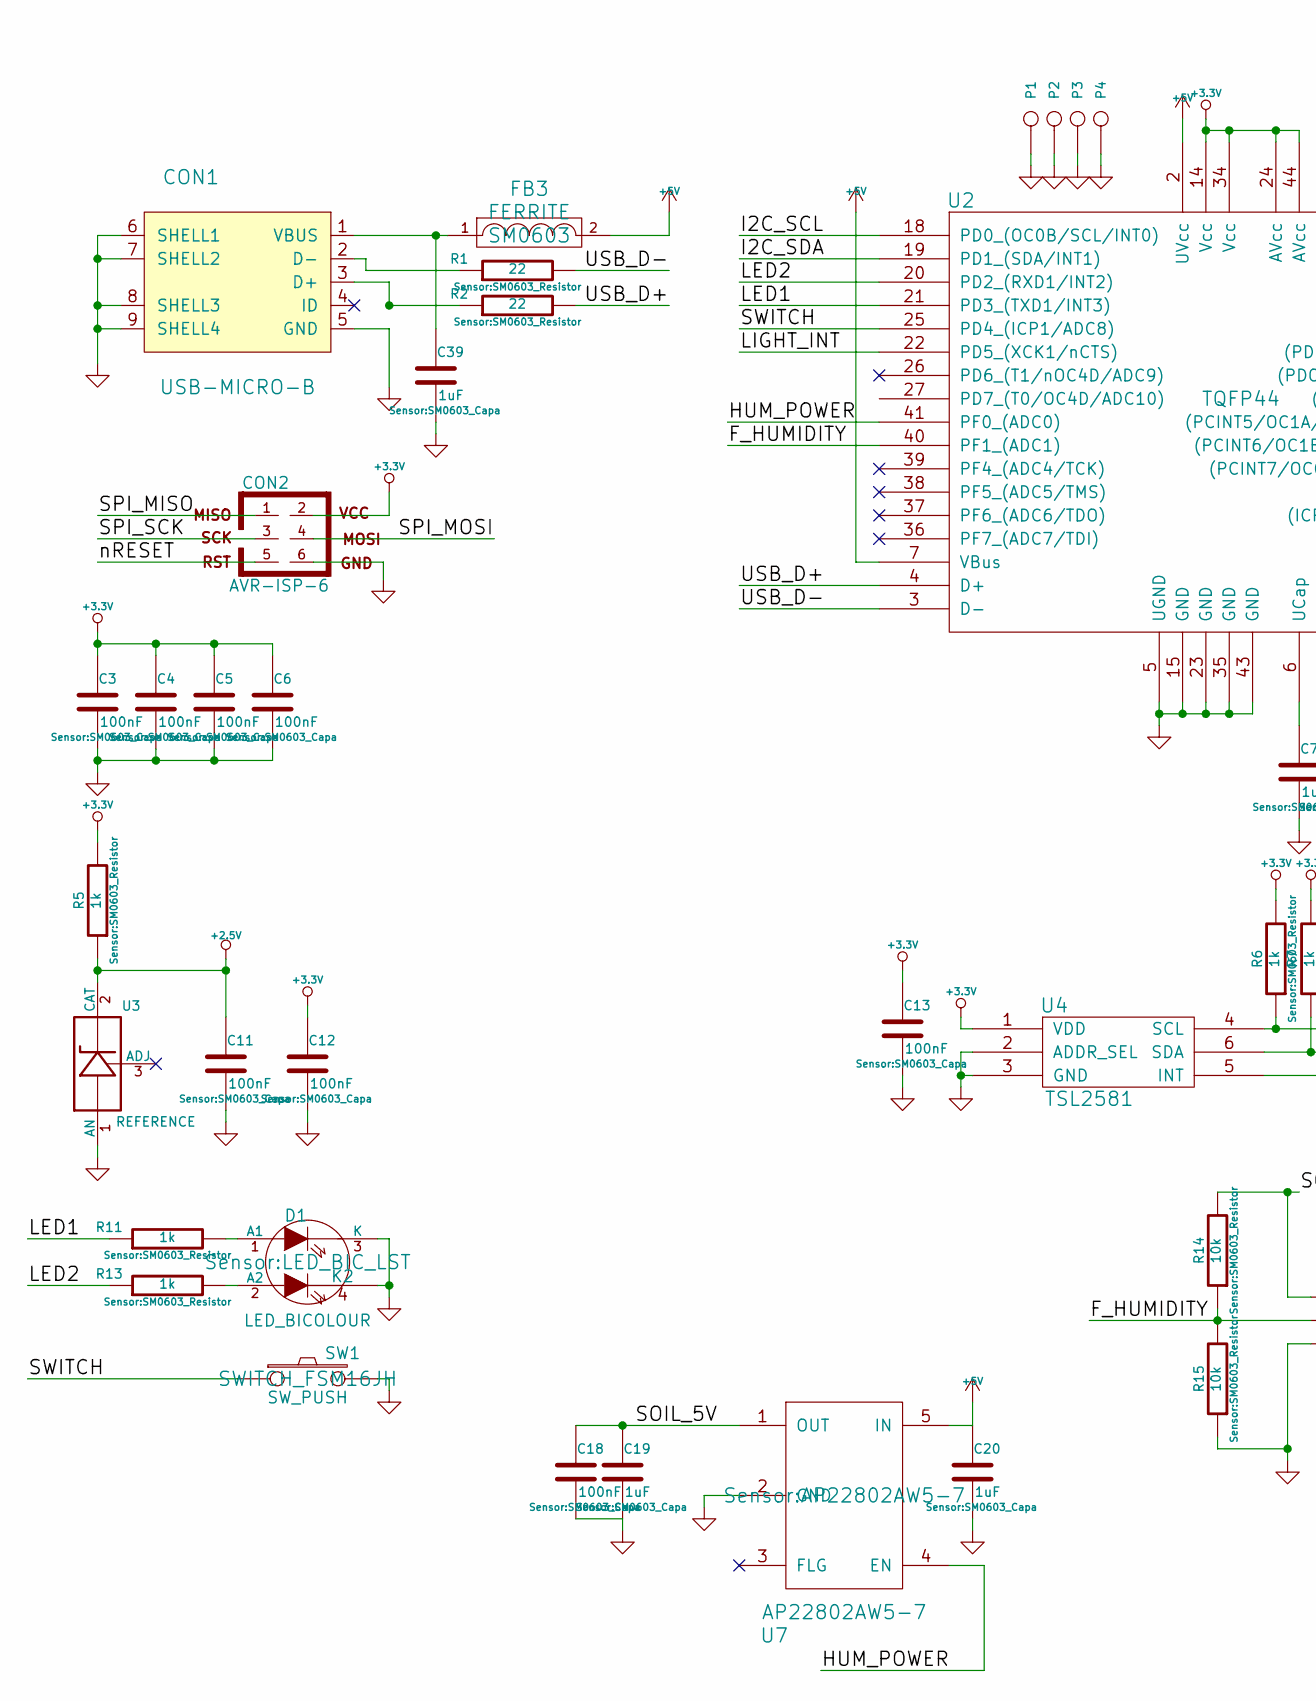
[picture p39: schematic sensor_station.sch, part in row 1, column 1]

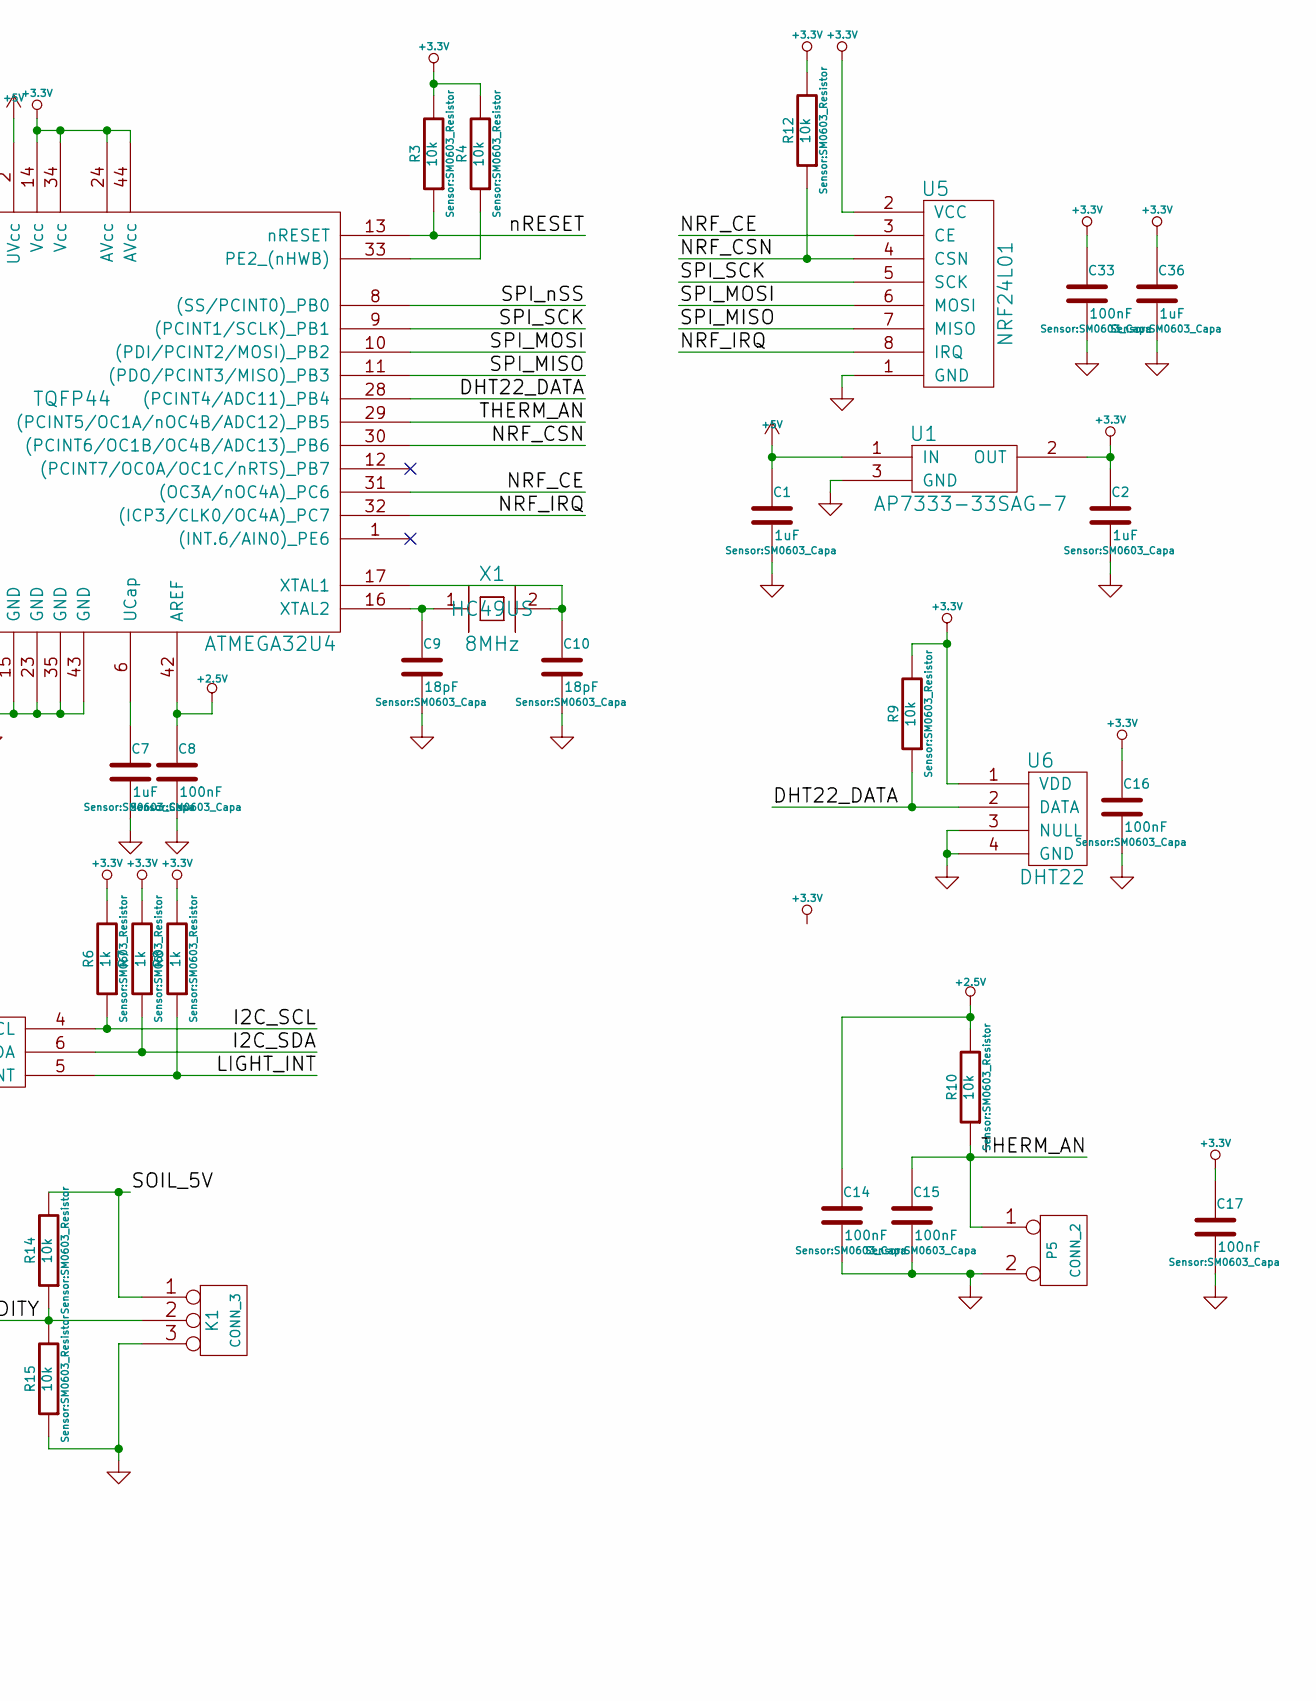
[picture p40: schematic sensor_station.sch, part in row 1, column 2]

Parts:
C1, C2, C7, C19, C20, C36, C39: 1uF; SM0603_Capa
C3, C4, C5, C6, C8, C11, C12, C13, C14, C15, C16, C17, C18, C33: 100nF; SM0603_Capa
C9, C10: 18pF; SM0603_Capa
CON1: USB-MICRO-B; con_microusb_10103594
CON2: AVR-ISP-6; pin_array_3x2
D1: LED_BICOLOUR; LED_BIC_LST
FB3: FERRITE; SM0603
K1: CONN_3; CON_3_weidmuller
P1, P2, P3, P4: CONN_1; HOLE_FIX_HAMMOND
P5: CONN_2; CON_2_weidmuller
R1, R2: 22; SM0603_Resistor
R3, R4, R9, R10, R12, R14, R15: 10k; SM0603_Resistor
R5, R6, R7, R8, R11, R13: 1k; SM0603_Resistor
SW1: SW_PUSH; SWITCH_FSM16JH
U1: AP7333-33SAG-7; SOT23
U2: ATMEGA32U4; TQFP44
U3: REFERENCE; TO92F
U4: TSL2581; 6-WDFN
U5: NRF24L01
U6: DHT22
U7: AP22802AW5-7
X1: 8MHz; HC49US

Connections:
+2.5V: C8.1, C11.1, C14.1, R5.1, R10.2, U2.42 (AREF), U3.2 (CAT)
+3.3V: C2.1, C3.1, C4.1, C5.1, C6.1, C12.1, C13.1, C16.1, C17.1, C33.1, C36.1, CON2.2, R3.2, R4.2, R5.2, R6.2, R7.2, R8.2, R9.2, R12.2, U1.2 (OUT), U2.14 (Vcc), U2.24 (AVcc), U2.34 (Vcc), U2.44 (AVcc), U4.1 (VDD), U5.2 (VCC), U6.1 (VDD)
+5V: C1.1, C20.1, FB3.2, U1.1 (IN), U2.2 (UVcc), U2.7 (VBus), U7.5 (IN)
/DHT22_DATA: R9.1, U2.28 ((PCINT4/ADC11)_PB4), U6.2 (DATA)
/F_HUMIDITY: K1.2 (PM), R14.1, R15.2, U2.40 (PF1_(ADC1))
/HUM_POWER: U2.41 (PF0_(ADC0)), U7.4 (EN)
/I2C_SCL: R6.1, U2.18 (PD0_(OC0B/SCL/INT0)), U4.4 (SCL)
/I2C_SDA: R7.1, U2.19 (PD1_(SDA/INT1)), U4.6 (SDA)
/LED1: R11.1, U2.21 (PD3_(TXD1/INT3))
/LED2: R13.1, U2.20 (PD2_(RXD1/INT2))
/LIGHT_INT: R8.1, U2.22 (PD5_(XCK1/nCTS)), U4.5 (INT)
/NRF_CE: U2.31 ((OC3A/nOC4A)_PC6), U5.3 (CE)
/NRF_CSN: R12.1, U2.30 ((PCINT6/OC1B/OC4B/ADC13)_PB6), U5.4 (CSN)
/NRF_IRQ: U2.32 ((ICP3/CLK0/OC4A)_PC7), U5.8 (IRQ)
/SOIL_5V: C18.1, C19.1, K1.1, R14.2, U7.1 (OUT)
/SPI_MISO: CON2.1, U2.11 ((PDO/PCINT3/MISO)_PB3), U5.7 (MISO)
/SPI_MOSI: CON2.4, U2.10 ((PDI/PCINT2/MOSI)_PB2), U5.6 (MOSI)
/SPI_SCK: CON2.3, U2.9 ((PCINT1/SCLK)_PB1), U5.5 (SCK)
/SPI_nSS: U2.8 ((SS/PCINT0)_PB0)
/SWITCH: SW1.1, U2.25 (PD4_(ICP1/ADC8))
/THERM_AN: C15.1, P5.1, R10.1, U2.29 ((PCINT5/OC1A/nOC4B/ADC12)_PB5)
/USB_D+: R2.2, U2.4 (D+)
/USB_D-: R1.2, U2.3 (D-)
/nRESET: CON2.5, R3.1, U2.13 (nRESET)
GND: C1.2, C2.2, C3.2, C4.2, C5.2, C6.2, C7.2, C8.2, C9.2, C10.2, C11.2, C12.2, C13.2, C14.2, C15.2, C16.2, C17.2, C18.2, C19.2, C20.2, C33.2, C36.2, C39.2, CON1.5 (GND), CON1.6 (SHELL1), CON1.7 (SHELL2), CON1.8 (SHELL3), CON1.9 (SHELL4), CON2.6, D1.3 (K), D1.4 (K2), K1.3, P1.1, P2.1, P3.1, P4.1, P5.2 (PM), R15.1, SW1.2, U1.3 (GND), U2.5 (UGND), U2.15 (GND), U2.23 (GND), U2.35 (GND), U2.43 (GND), U3.1 (AN), U4.2 (ADDR_SEL), U4.3 (GND), U5.1 (GND), U6.3 (NULL), U6.4 (GND), U7.2 (GND); also elsewhere on the board
unnamed: C7.1, U2.6 (UCap)
unnamed: C9.1, U2.16 (XTAL2), X1.1
unnamed: C10.1, U2.17 (XTAL1), X1.2
unnamed: C39.1, CON1.1 (VBUS), FB3.1
unnamed: CON1.2 (D-), R1.1
unnamed: CON1.3 (D+), R2.1
unnamed: D1.1 (A1), R11.2
unnamed: D1.2 (A2), R13.2
unnamed: R4.1, U2.33 (PE2_(nHWB))

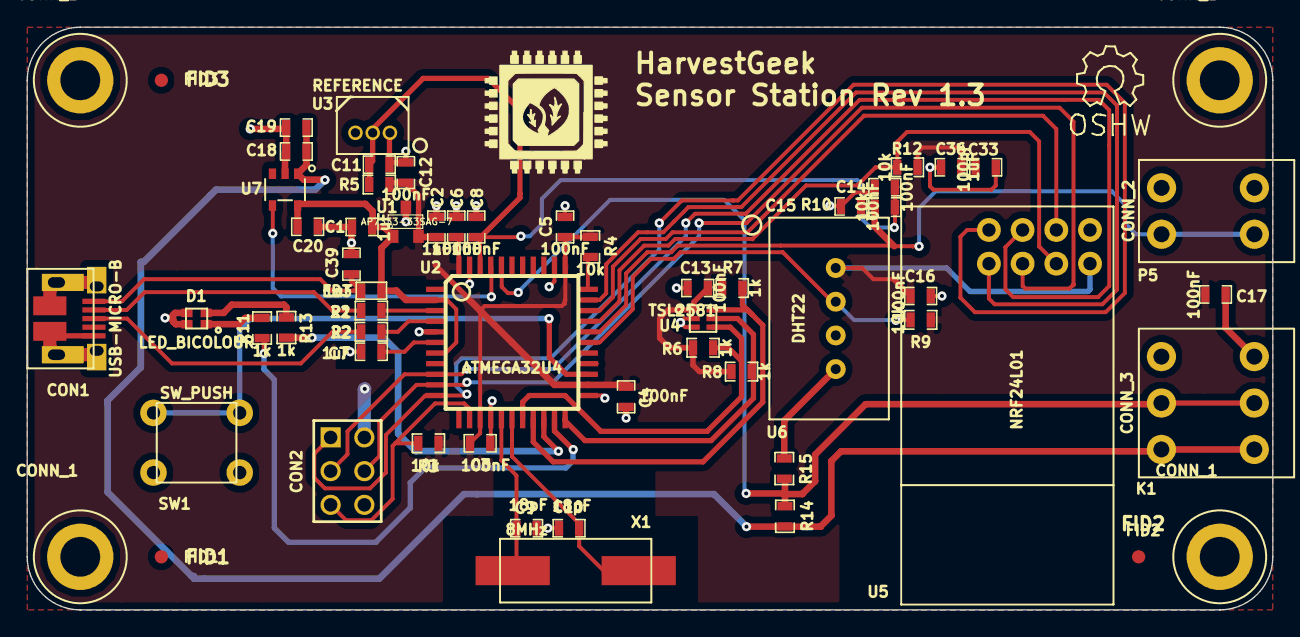
[picture p41: board sensor_station.kicad_pcb from above]

Board: 2 copper layers, 93.9 x 43.9 mm, 60 parts (0 on the bottom side), 33 nets.

Other parts of the board:
Fiducial: FID3; Fiducial
Fiducial#2: FID2; Fiducial
Fiducial#3: FID1; Fiducial
P1#2, P1#3, P1#4: CONN_1; HOLE_FIX_HAMMOND

Their connections:
GND: P1#2.1, P1#3.1, P1#4.1; also elsewhere on the board
