rowangifford/harvestgeek/Hardware/Kicad/Moisture_probe_rev1.0_07JUN/moisture_probe.kicad_pcb

## KiCad design Hardware/Kicad/Moisture_probe_rev1.0_07JUN/moisture_probe.kicad_pcb (2015-06-23)

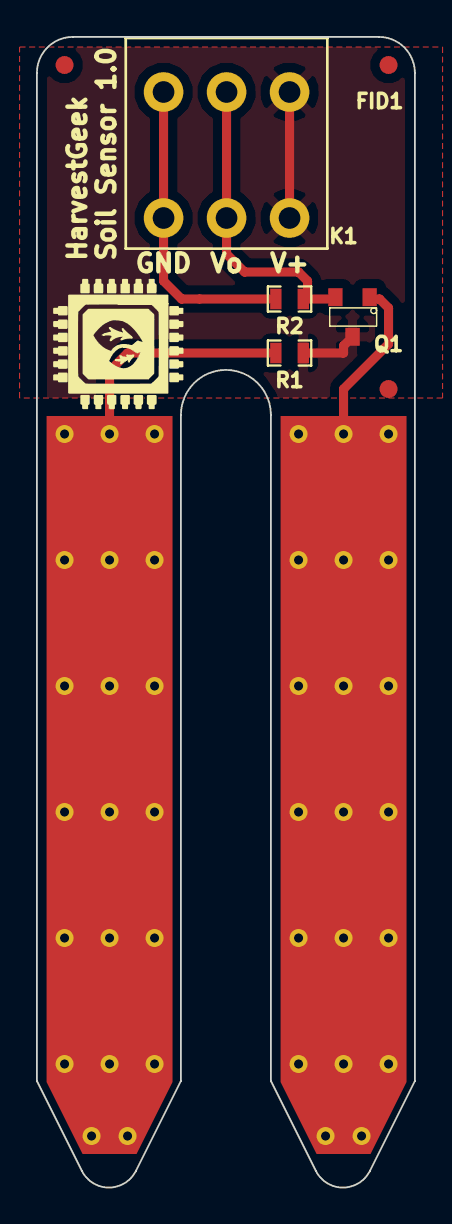
[picture p42: board moisture_probe.kicad_pcb from above]

Board: 2 copper layers, 21.0 x 63.9 mm, 9 parts (0 on the bottom side), 5 nets.

Parts:
Fiducial: FID1; Fiducial
Fiducial#2, Fiducial#3: FID1; Fiducial
K1: CONN_3; CON_3_weidmuller
P1, P2: CONN_01X01; probe
Q1: MMBT2222ALT3G; SOT23
R1, R2: 100R; SM0603_Resistor

Connections:
unnamed: K1.1, Q1.3, R1.2
unnamed: K1.2, Q1.2, R2.2
unnamed: K1.3, R2.1
unnamed: P1.1, Q1.1
unnamed: P2.1, R1.1
