rowangifford/harvestgeek/Hardware/Kicad/base_station_rev1.2_16MAY/base_station.kicad_pcb

## KiCad design Hardware/Kicad/base_station_rev1.2_16MAY/base_station.kicad_pcb (2015-05-17)

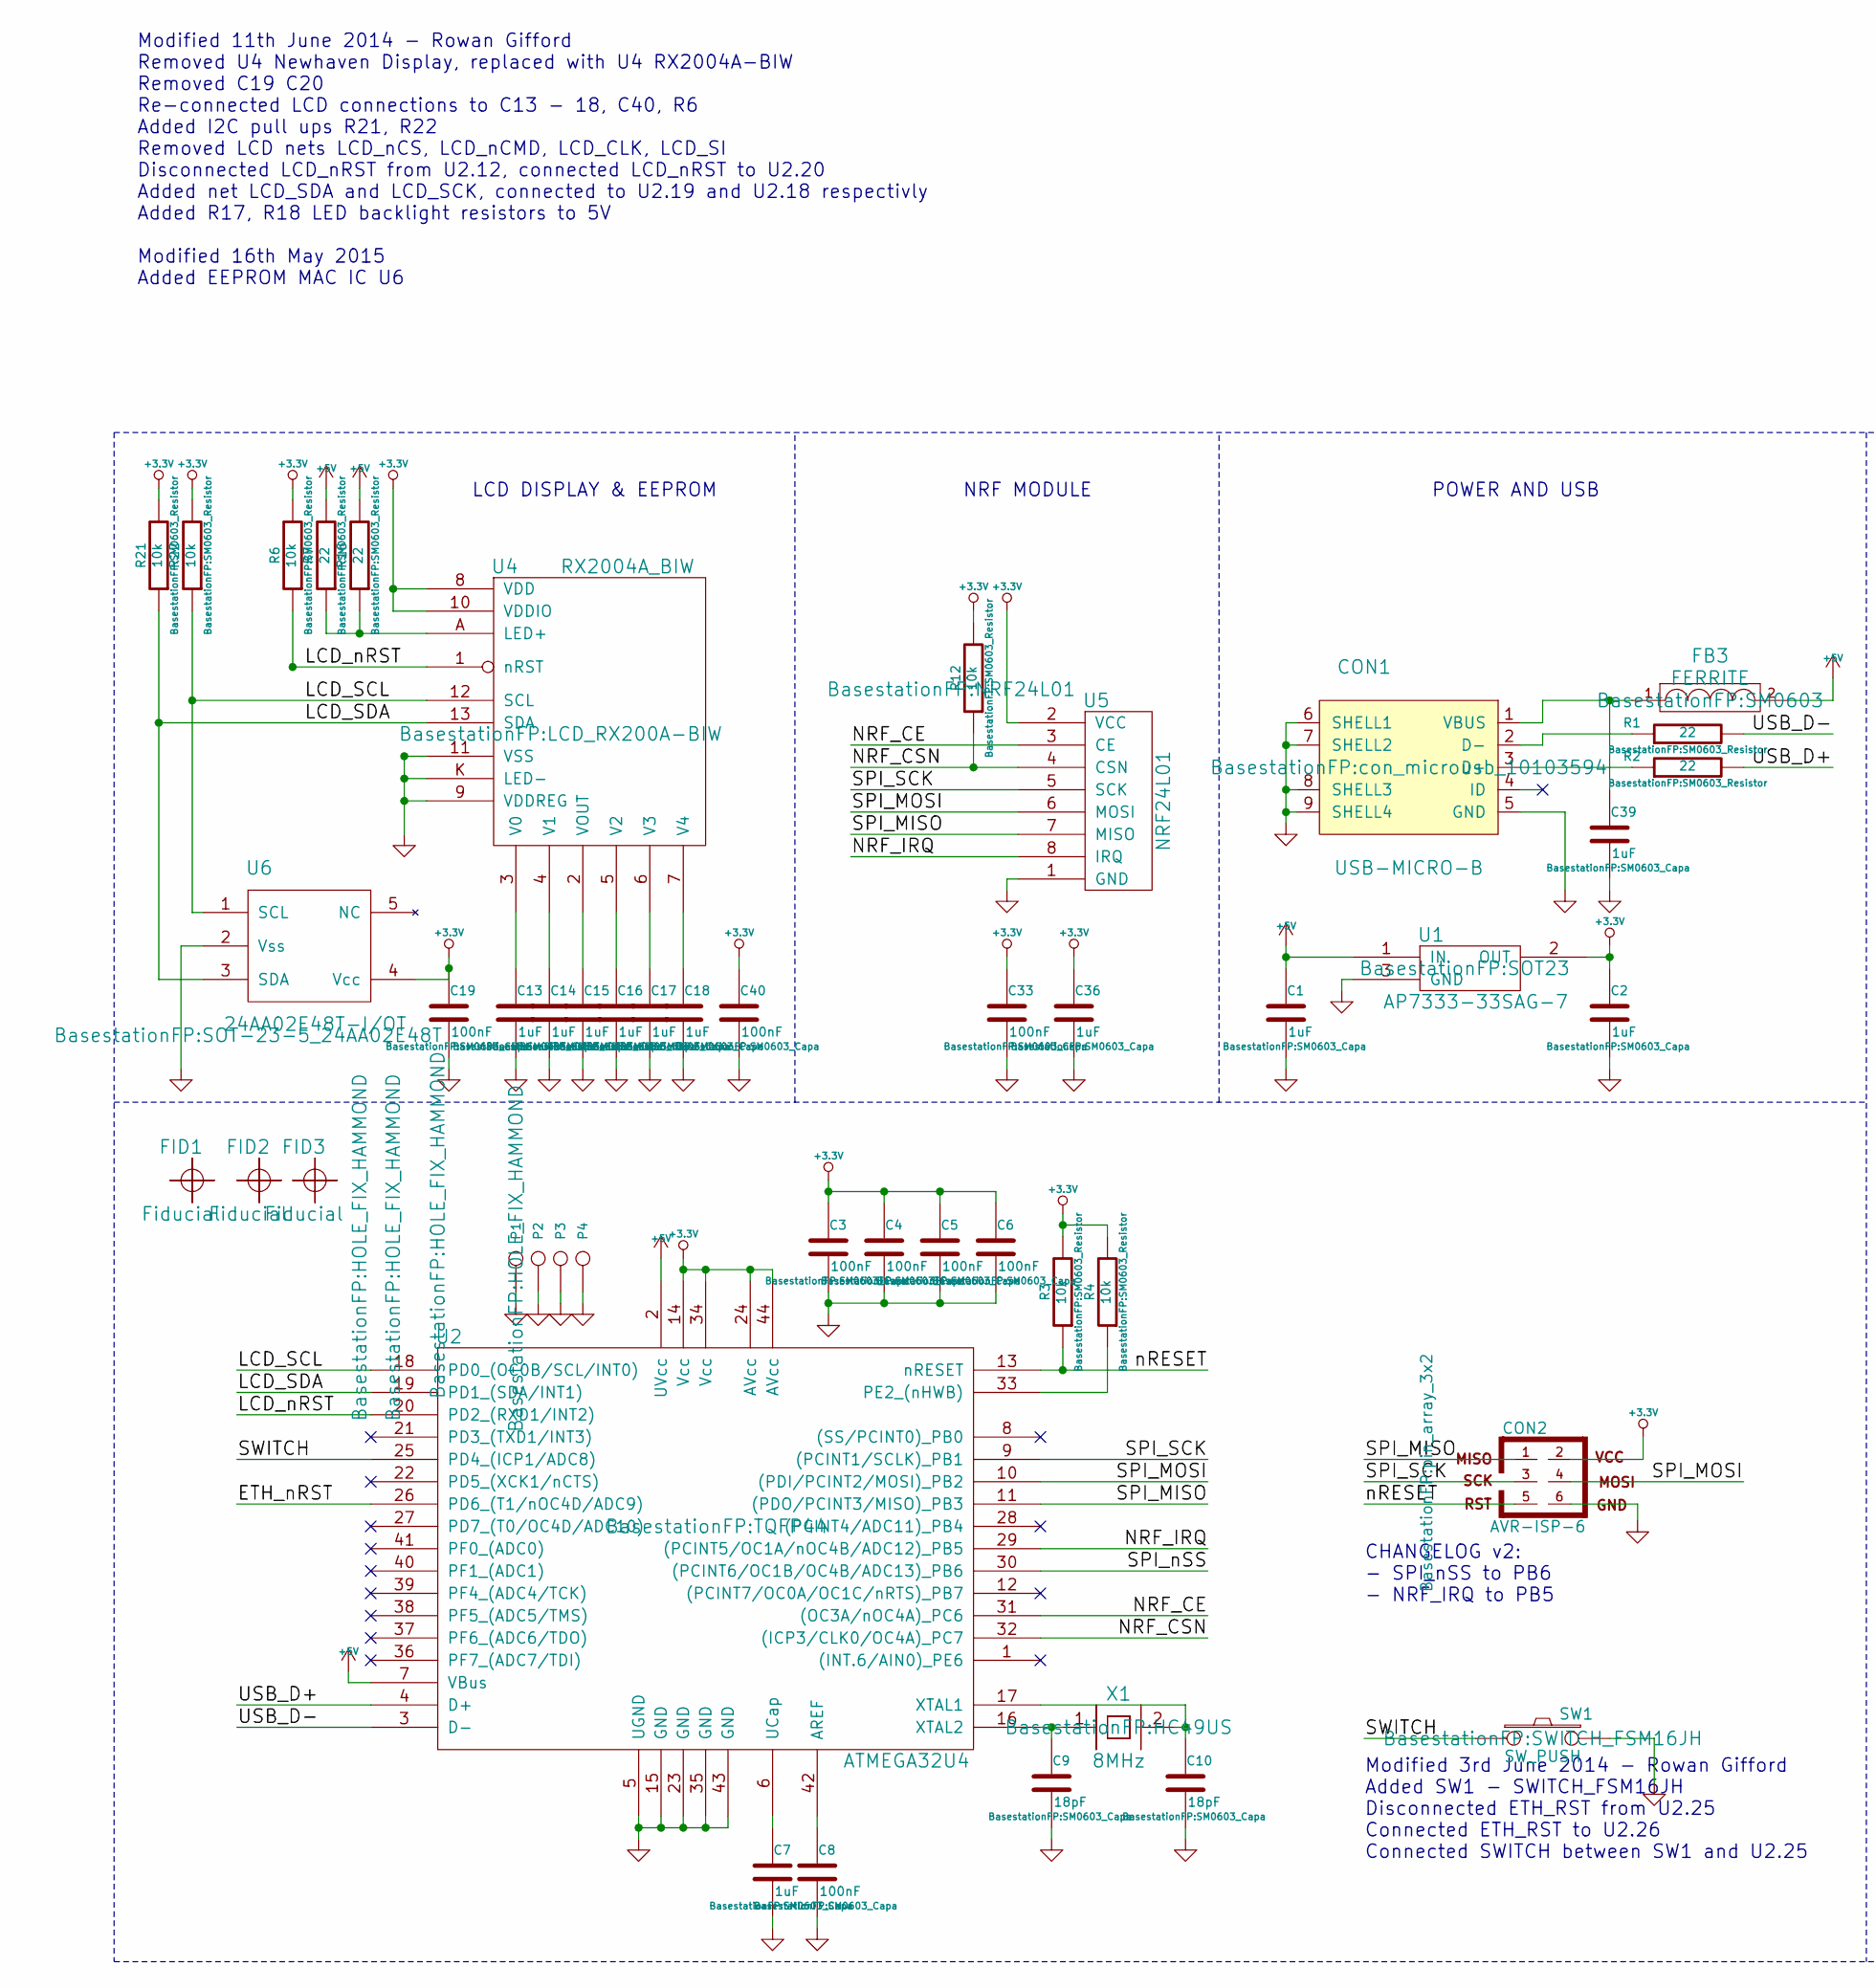
[picture p43: schematic base_station.sch, part in row 1, column 1]

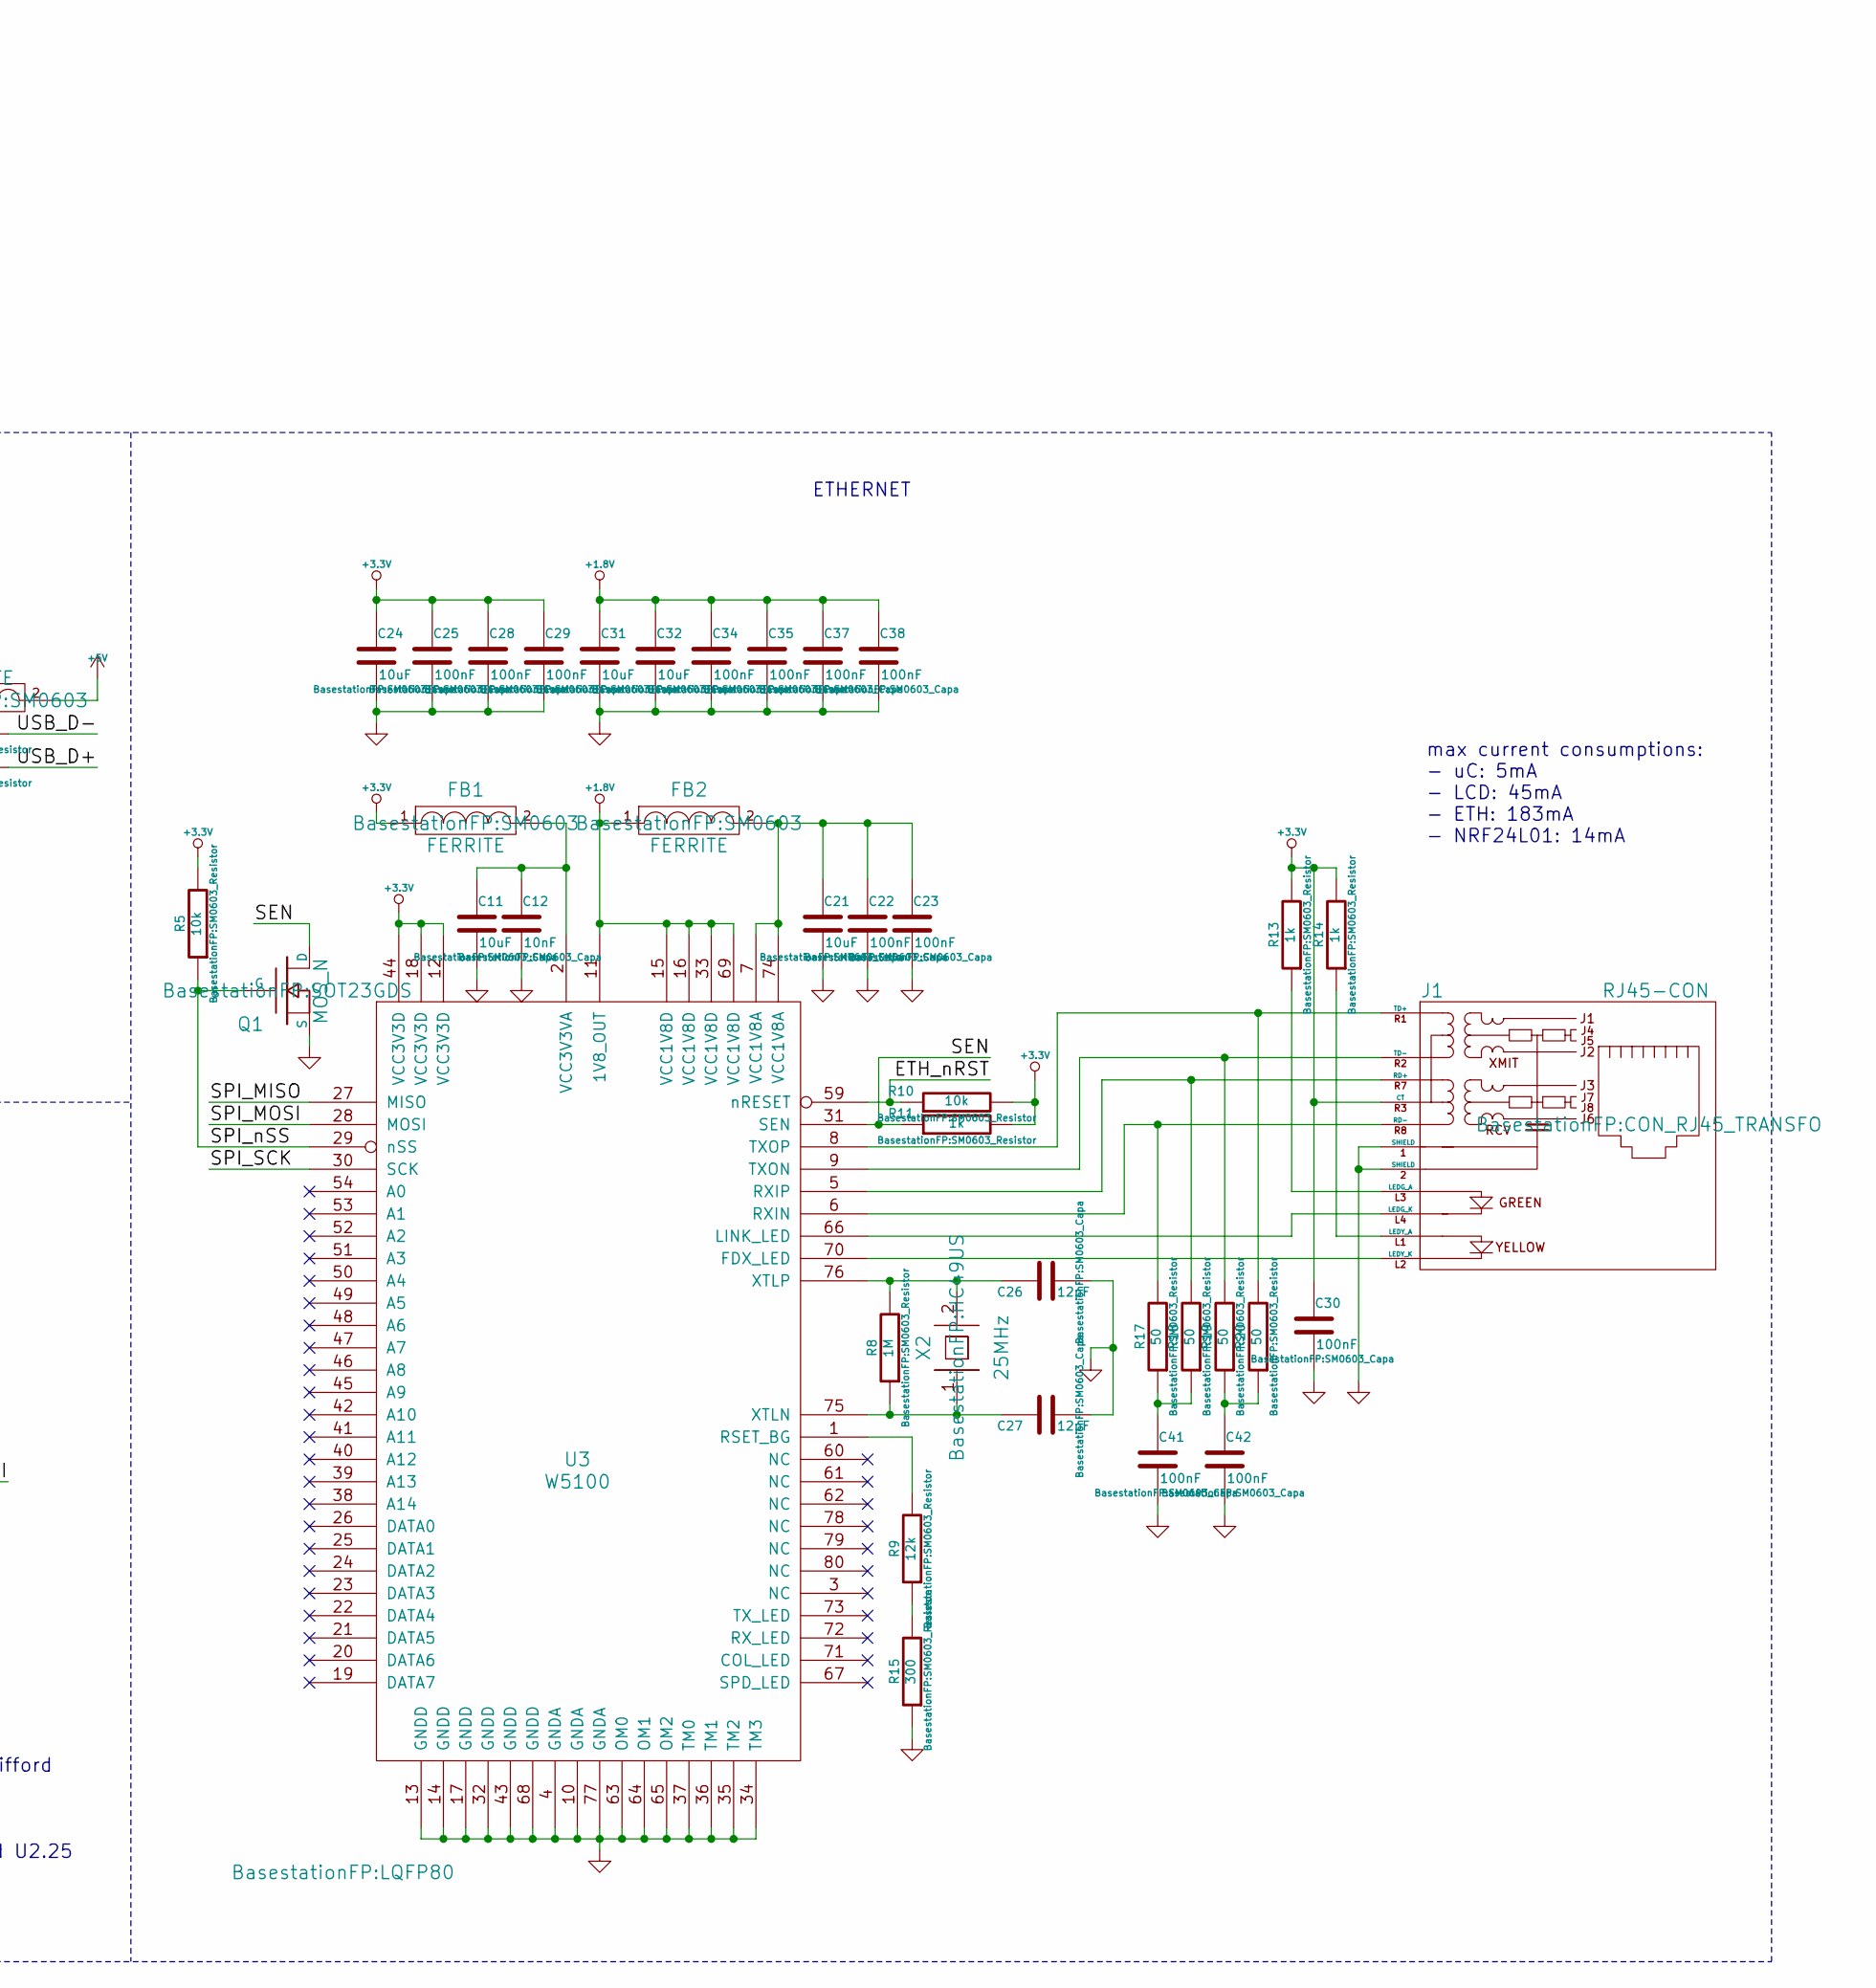
[picture p44: schematic base_station.sch, part in row 1, column 2]

Parts:
C1, C2, C7, C13, C14, C15, C16, C17, C18, C36, C39: 1uF; SM0603_Capa
C3, C4, C5, C6, C8, C19, C22, C23, C25, C28, C29, C30, C33, C34, C35, C37, C38, C40, C41, C42: 100nF; SM0603_Capa
C9, C10: 18pF; SM0603_Capa
C11, C21, C24, C31, C32: 10uF; SM0603_Capa
C12: 10nF; SM0603_Capa
C26, C27: 12pF; SM0603_Capa
CON1: USB-MICRO-B; con_microusb_10103594
CON2: AVR-ISP-6; pin_array_3x2
FB1, FB2, FB3: FERRITE; SM0603
FID1, FID2, FID3: Fiducial
J1: RJ45-CON; CON_RJ45_TRANSFO
P1, P2, P3, P4: CONN_1; HOLE_FIX_HAMMOND
Q1: MOS_N; SOT23GDS
R1, R2, R7, R16: 22; SM0603_Resistor
R3, R4, R5, R6, R10, R12, R21, R22: 10k; SM0603_Resistor
R8: 1M; SM0603_Resistor
R9: 12k; SM0603_Resistor
R11, R13, R14: 1k; SM0603_Resistor
R15: 300; SM0603_Resistor
R17, R18, R19, R20: 50; SM0603_Resistor
SW1: SW_PUSH; SWITCH_FSM16JH
U1: AP7333-33SAG-7; SOT23
U2: ATMEGA32U4; TQFP44
U3: W5100; LQFP80
U4: RX2004A_BIW; LCD_RX200A-BIW
U5: NRF24L01
U6: 24AA02E48T-I/OT; SOT-23-5_24AA02E48T
X1: 8MHz; HC49US
X2: 25MHz; HC49US

Connections:
+1.8V: C31.1, C32.1, C34.1, C35.1, C37.1, C38.1, FB2.1, U3.11 (1V8_OUT), U3.15 (VCC1V8D), U3.16 (VCC1V8D), U3.33 (VCC1V8D), U3.69 (VCC1V8D)
+3.3V: C2.1, C3.1, C4.1, C5.1, C6.1, C19.1, C24.1, C25.1, C28.1, C29.1, C30.1, C33.1, C36.1, C40.1, CON2.2, FB1.1, J1.R3 (CT), R3.2, R4.2, R5.2, R6.2, R10.2, R11.2, R12.2, R13.2, R14.2, R21.2, R22.2, U1.2 (OUT), U2.14 (Vcc), U2.24 (AVcc), U2.34 (Vcc), U2.44 (AVcc), U3.12 (VCC3V3D), U3.18 (VCC3V3D), U3.44 (VCC3V3D), U4.8 (VDD), U4.10 (VDDIO), U5.2 (VCC), U6.4 (Vcc)
+5V: C1.1, FB3.2, R7.2, R16.2, U1.1 (IN), U2.2 (UVcc), U2.7 (VBus)
/ETH_nRST: R10.1, U2.26 (PD6_(T1/nOC4D/ADC9)), U3.59 (nRESET)
/LCD_SCL: R22.1, U2.18 (PD0_(OC0B/SCL/INT0)), U4.12 (SCL), U6.1 (SCL)
/LCD_SDA: R21.1, U2.19 (PD1_(SDA/INT1)), U4.13 (SDA), U6.3 (SDA)
/LCD_nRST: R6.1, U2.20 (PD2_(RXD1/INT2)), U4.1 (nRST)
/NRF_CE: U2.31 ((OC3A/nOC4A)_PC6), U5.3 (CE)
/NRF_CSN: R12.1, U2.32 ((ICP3/CLK0/OC4A)_PC7), U5.4 (CSN)
/NRF_IRQ: U2.29 ((PCINT5/OC1A/nOC4B/ADC12)_PB5), U5.8 (IRQ)
/SEN: Q1.D, R11.1, U3.31 (SEN)
/SPI_MISO: CON2.1, U2.11 ((PDO/PCINT3/MISO)_PB3), U3.27 (MISO), U5.7 (MISO)
/SPI_MOSI: CON2.4, U2.10 ((PDI/PCINT2/MOSI)_PB2), U3.28 (MOSI), U5.6 (MOSI)
/SPI_SCK: CON2.3, U2.9 ((PCINT1/SCLK)_PB1), U3.30 (SCK), U5.5 (SCK)
/SPI_nSS: Q1.G, R5.1, U2.30 ((PCINT6/OC1B/OC4B/ADC13)_PB6), U3.29 (nSS)
/SWITCH: SW1.1, U2.25 (PD4_(ICP1/ADC8))
/USB_D+: R2.2, U2.4 (D+)
/USB_D-: R1.2, U2.3 (D-)
/nRESET: CON2.5, R3.1, U2.13 (nRESET)
GND: C1.2, C2.2, C3.2, C4.2, C5.2, C6.2, C7.2, C8.2, C9.2, C10.2, C11.2, C12.2, C13.2, C14.2, C15.2, C16.2, C17.2, C18.2, C19.2, C21.2, C22.2, C23.2, C24.2, C25.2, C26.2, C27.2, C28.2, C29.2, C30.2, C31.2, C32.2, C33.2, C34.2, C35.2, C36.2, C37.2, C38.2, C39.2, C40.2, C41.2, C42.2, CON1.5 (GND), CON1.6 (SHELL1), CON1.7 (SHELL2), CON1.8 (SHELL3), CON1.9 (SHELL4), CON2.6, J1.1 (SHIELD), J1.2 (SHIELD), P1.1, P2.1, P3.1, P4.1, Q1.S, R15.1, SW1.2, U1.3 (GND), U2.5 (UGND), U2.15 (GND), U2.23 (GND), U2.35 (GND), U2.43 (GND), U3.4 (GNDA), U3.10 (GNDA), U3.13 (GNDD), U3.14 (GNDD), U3.17 (GNDD), U3.32 (GNDD), U3.34 (TM3), U3.35 (TM2), U3.36 (TM1), U3.37 (TM0), U3.43 (GNDD), U3.63 (OM0), U3.64 (OM1), U3.65 (OM2), U3.68 (GNDD), U3.77 (GNDA), U4.9 (VDDREG), U4.11 (VSS), U4.K (LED-), U5.1 (GND), U6.2 (Vss)
unnamed: C7.1, U2.6 (UCap)
unnamed: C8.1, U2.42 (AREF)
unnamed: C9.1, U2.16 (XTAL2), X1.1
unnamed: C10.1, U2.17 (XTAL1), X1.2
unnamed: C11.1, C12.1, FB1.2, U3.2 (VCC3V3VA)
unnamed: C13.1, U4.3 (V0)
unnamed: C14.1, U4.4 (V1)
unnamed: C15.1, U4.2 (VOUT)
unnamed: C16.1, U4.5 (V2)
unnamed: C17.1, U4.6 (V3)
unnamed: C18.1, U4.7 (V4)
unnamed: C21.1, C22.1, C23.1, FB2.2, U3.7 (VCC1V8A), U3.74 (VCC1V8A)
unnamed: C26.1, R8.2, U3.76 (XTLP), X2.2
unnamed: C27.1, R8.1, U3.75 (XTLN), X2.1
unnamed: C39.1, CON1.1 (VBUS), FB3.1
unnamed: C41.1, R17.1, R18.1
unnamed: C42.1, R19.1, R20.1
unnamed: CON1.2 (D-), R1.1
unnamed: CON1.3 (D+), R2.1
unnamed: J1.L1 (LEDY_A), R14.1
unnamed: J1.L2 (LEDY_K), U3.70 (FDX_LED)
unnamed: J1.L3 (LEDG_A), R13.1
unnamed: J1.L4 (LEDG_K), U3.66 (LINK_LED)
unnamed: J1.R1 (TD+), R20.2, U3.8 (TXOP)
unnamed: J1.R2 (TD-), R19.2, U3.9 (TXON)
unnamed: J1.R7 (RD+), R18.2, U3.5 (RXIP)
unnamed: J1.R8 (RD-), R17.2, U3.6 (RXIN)
unnamed: R4.1, U2.33 (PE2_(nHWB))
unnamed: R9.2, U3.1 (RSET_BG)
unnamed: R9.1, R15.2
unnamed: R7.1, R16.1, U4.A (LED+)

Notes on the sheet:
max current consumptions: - uC: 5mA - LCD: 45mA - ETH: 183mA - NRF24L01: 14mA
LCD DISPLAY & EEPROM
NRF MODULE
POWER AND USB
ETHERNET
CHANGELOG v2: - SPI_nSS to PB6 - NRF_IRQ to PB5
Modified 3rd June 2014 - Rowan Gifford Added SW1 - SWITCH_FSM16JH Disconnected ETH_RST from U2.25 Connected ETH_RST to U2.26 Connected SWITCH between SW1 and U2.25
Modified 11th June 2014 - Rowan Gifford Removed U4 Newhaven Display, replaced with U4 RX2004A-BIW Removed C19 C20 Re-connected LCD connections to C13 - 18, C40, R6 Added I2C pull ups R21, R22 Removed LCD nets LCD_nCS, LCD_nCMD, LCD_CLK, LCD_SI Disconnected LCD_nRST from U2.12, connected LCD_nRST to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

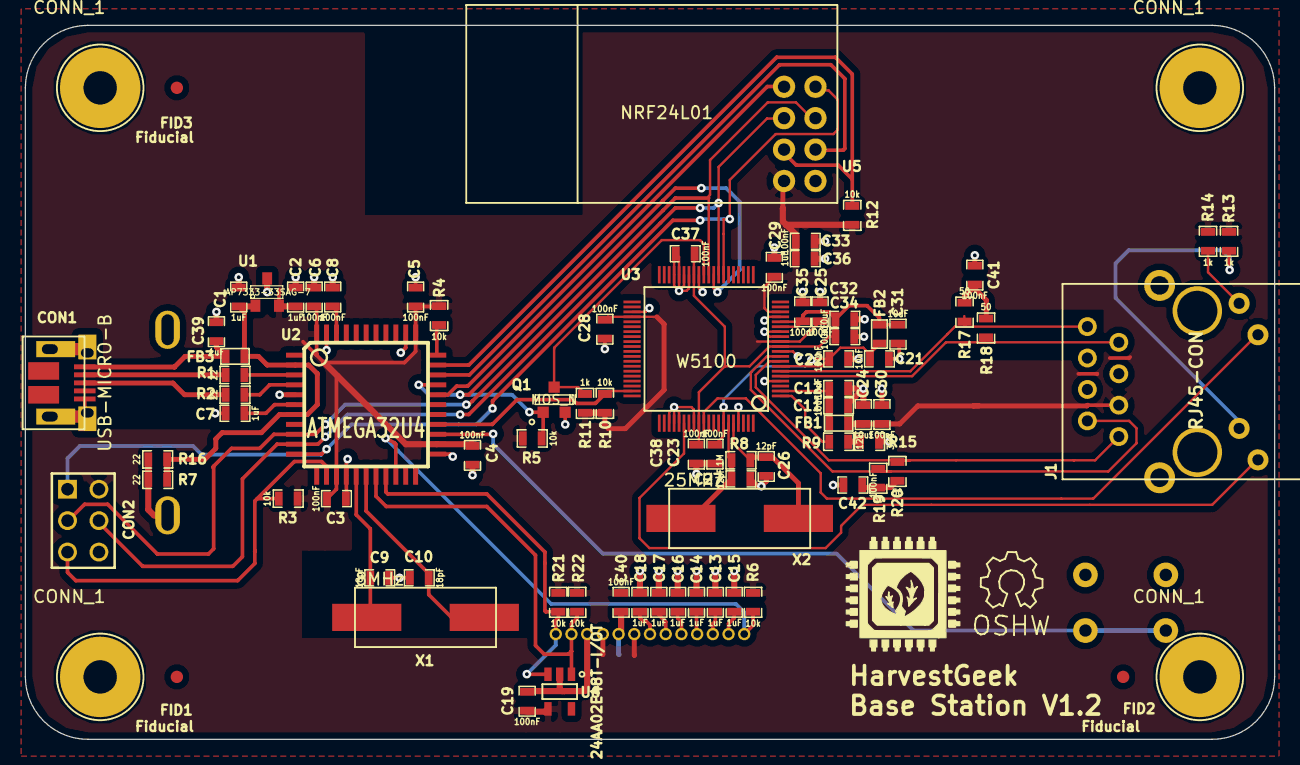
[picture p45: board base_station.kicad_pcb from above]

Board: 2 copper layers, 101.0 x 57.7 mm, 86 parts (0 on the bottom side), 51 nets.
