rowangifford/harvestgeek/(commit log)

2015-05-16 Add kikcad
    [$base_station.sch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]
2015-05-17 Modified HW - BS gerbers
    [$base_station.sch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]
2015-05-22 Sensor Station PCB updates
    [SENSORSTATION_ASSY.gto, SENSORSTATION_BOARD_OUTLINE.gbr, SENSORSTATION_BOTMASK.gbs, SENSORSTATION_BOTTOM.gbl, SENSORSTATION_BOTTOM_COPPER.gbl, SENSORSTATION_BOTTOM_MASK.gbs, SENSORSTATION_DRILL.drl, SENSORSTATION_SILKTOP.gto]
2015-05-22 Sensor Station PCB updates2
    [SENSORSTATION_ASSY.gto, SENSORSTATION_BOARD_OUTLINE.gbr, SENSORSTATION_BOTMASK.gbs, SENSORSTATION_BOTTOM.gbl, SENSORSTATION_BOTTOM_COPPER.gbl, SENSORSTATION_BOTTOM_MASK.gbs, SENSORSTATION_DRILL.drl, SENSORSTATION_SILKTOP.gto]
2015-05-23 Added manufacturing files
    [BASESTATION_BOARD_OUTLINE.gbr, BASESTATION_BOTTOM_COPPER.gbl, BASESTATION_BOTTOM_MASK.gbs, BASESTATION_BOTTOM_SILK.gbo, BASESTATION_DRILL.drl, BASESTATION_TOP_COPPER.gtl, BASESTATION_TOP_MASK.gts, BASESTATION_TOP_PASTE.gtp]
2015-05-29 Latest manufacturing outputs
    [BASESTATION_BOARD_OUTLINE.gbr, BASESTATION_BOTTOM_COPPER.gbl, BASESTATION_BOTTOM_MASK.gbs, BASESTATION_BOTTOM_SILK.gbo, BASESTATION_DRILL.drl, BASESTATION_TOP_COPPER.gtl, BASESTATION_TOP_MASK.gts, BASESTATION_TOP_PASTE.gtp]
2015-06-23 23/06/2015 RG
    [BoM_MoistureProbe_Rev1.0.xlsm, BoM_SensorStation_Rev1.2.xlsm, BoM_SensorStation_Rev1.3.xlsm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]
